apistol78/retrodack/docs/parts.ods

Name | JLCPCB PN | Manufacturer PN | Price | Misc
SODIMM DDR2 connector | C428482 | 1473005-4 | 3.858
SODIMM DDR2 connector | C86474 | 1473005-1 | 3.993
HyperPixel 4 screen |  |  |  | 150 mA
ECP5 |  |  |  | 700 mA
SRAM | C2959389 | CY7C1061G30-10ZSXI | 28.4115 | 16 Mbit | 5 | Fmax = 110
SD card connector | C569097 | 10067847-001RLF | 1.335
SD card connector | C506790 | DM1AA-SF-PEJ(82) | 2.8245
I2S sound DAC | C1520745 | CS4344-CZZ | Discontinued | Discontinued | Discontinued | Discontinued
Speakers |  | JST 1.25
Speakers Amplifier |  | MAX9715xTE+
Speakers Amplifier | C7717 | TPA2012D2RTJR
Headphone Amplifier | C2864655 | TPA4411RTJR
Battery connector |  | JST-PH
USB C charge port
Battery management IC | C81080 | BQ24040DSQR | 0.3314
Linear regulator 3V3 (for display) | C2877852 | TLV75801PDBVR
Buck boost reg 5V0 (for display) | C116655 | TPS63002DRCR
ESD | C328026 | ESD7104MUTAG
USB IC | C2651881 | MAX3421EEHJ+T
Inductor | C36409 | SWPA4030S2R2MT
Tantalum Cap | C7190 | TAJA476K006RNJ
https://www.youtube.com/watch?v=wy2Sr5DGSmc
