apistol78/retrodack/schematics/audio_eval01/audio_eval01/jlcpcb/production_files/BOM-audio.csv

Comment | Designator | Footprint | LCSC | Quantity
22uF | C11,C13,C2,C3,C5,C7,C9 | C_0805_2012Metric_Pad1.18x1.45mm_HandSolder | C15850 | 7
4k7 | R1,R2,R3 | R_0805_2012Metric_Pad1.20x1.40mm_HandSolder | C17673 | 3
~ | U1 | QFN50P500X500X100-33N | C2667049 | 1
0.1uF | C1,C10,C12,C14,C4,C6,C8 | C_0805_2012Metric_Pad1.18x1.45mm_HandSolder | C28233 | 7
AMS1117-1.8 | U2 | SOT-223-3_TabPin2 | C6185 | 1
47uF | C25 | CP_EIA-3216-18_Kemet-A | C7190 | 1
Conn_01x02_Pin | J3 | PinHeader_1x02_P2.54mm_Vertical |  | 1
Conn_01x10_Pin | J1 | PinHeader_1x10_P2.54mm_Vertical |  | 1
AudioJack3 | J2 | Jack_3.5mm_Switronic_ST-005-G_horizontal |  | 1
