apistol78/retrodack/schematics/mainboard/mainboard.step

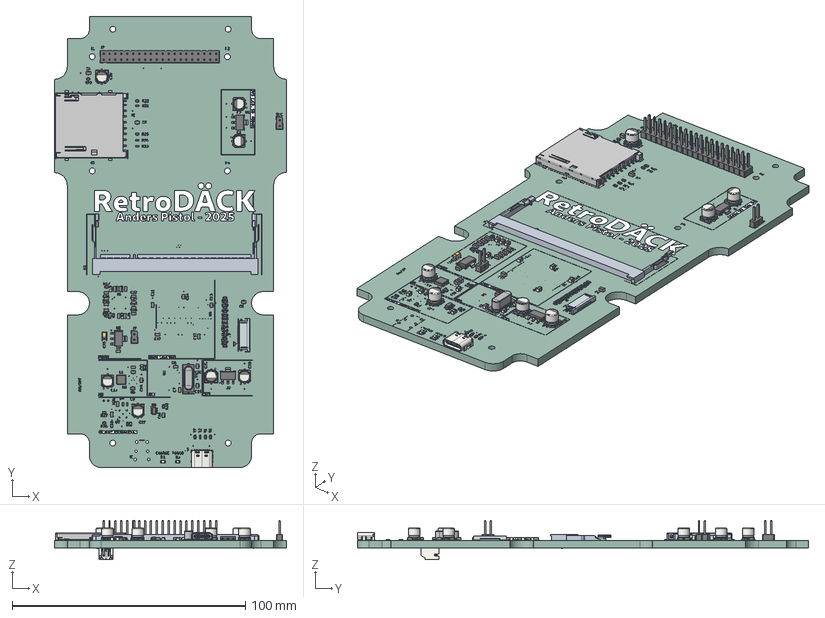
[picture p14: CAD file, 2025-05-28]
schematics/mainboard/mainboard.step
99.5 x 193.5 x 16.8 mm
SOT-223 x 3
PinHeader_1x02_P2.54mm_Vertical x 2
R_0603_1608Metric x 31
C_0805_2012Metric x 32
CP_Elec_5x5.3 x 7
LED_0805_2012Metric x 2
R_0805_2012Metric
L_APV_ANR4012
CP_EIA-3216-18_Kemet-A
Crystal_SMD_HC49-SD
RetroDACK SD_Hirose_DM1AA_SF_PEJ82
USB_C_Receptacle_GCT_USB4105-xx-A_16P_TopMnt_Horizontal
PinHeader_2x20_P2.54mm_Vertical
SOT-23-6
JST_PH_S2B-PH-K_1x02_P2.00mm_Horizontal
mainboard_silkscreen
mainboard_PCB
