apistol78/retrodack/schematics/buttboard/buttboard/buttboard.step

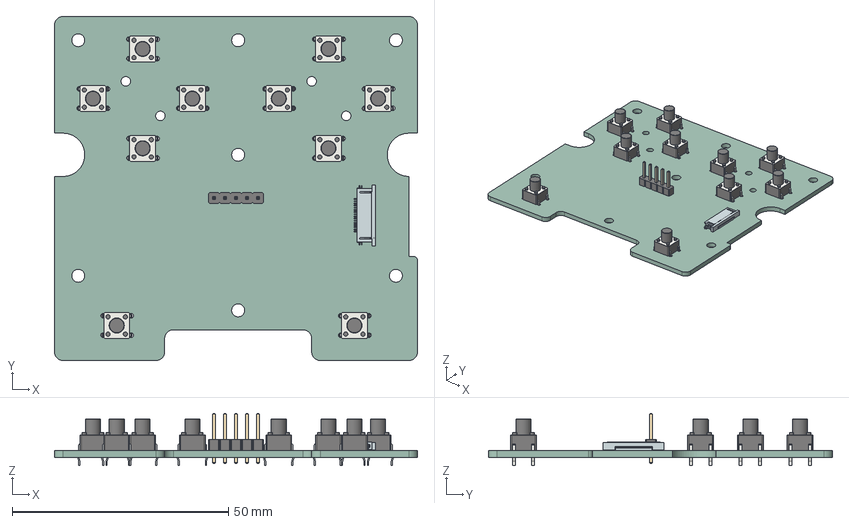
[picture p15: CAD file, 2025-07-03]
schematics/buttboard/buttboard/buttboard.step
84.0 x 79.6 x 12.0 mm
PinHeader_1x05_P2.54mm_Vertical
SW_PUSH_6mm_H7.3mm x 10
buttboard_PCB
