apistol78/retrodack/docs/C145812.pdf

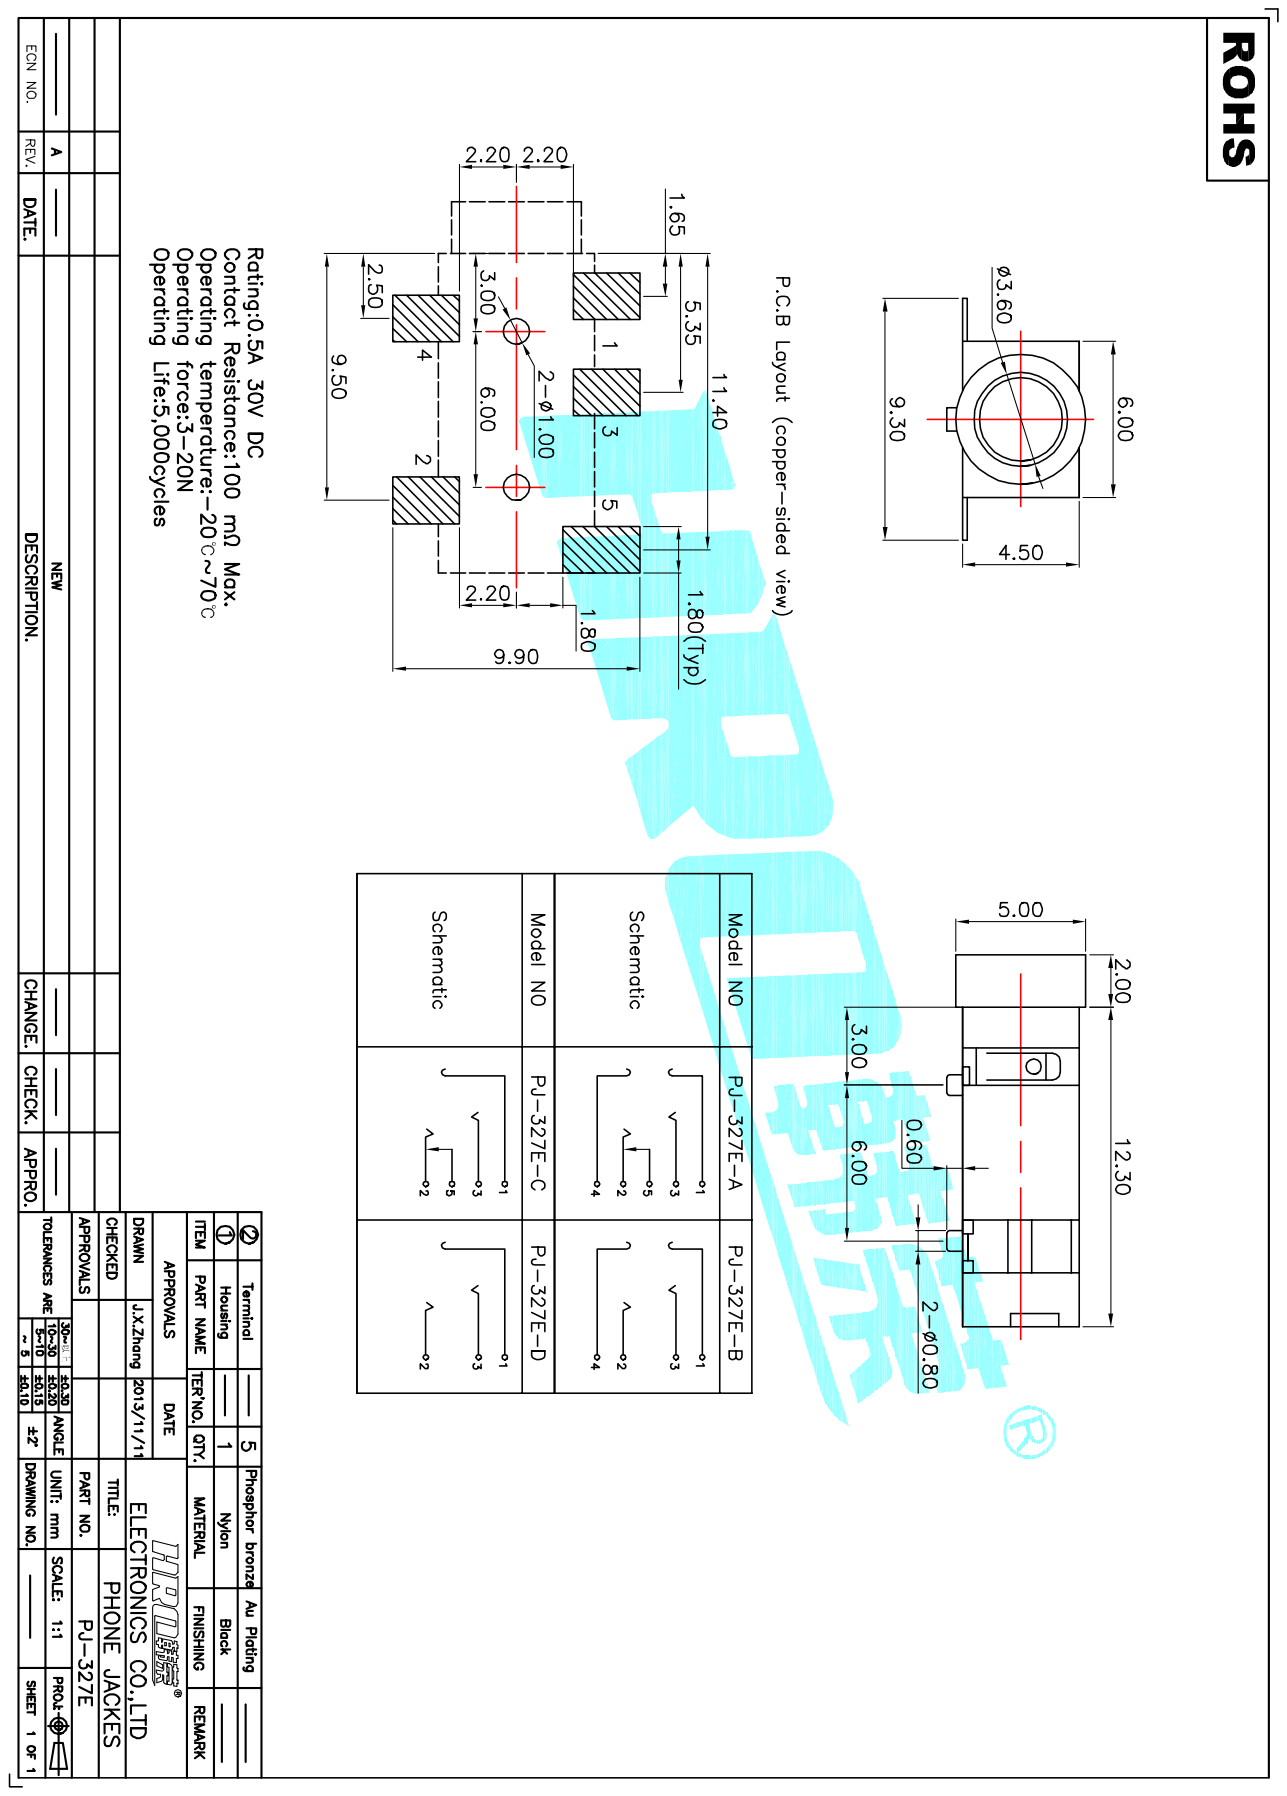
[picture p16: page 1]
