apistol78/retrodack/schematics/fpgaboard/fpgaboard/fpgaboard.kicad_pcb

## KiCad design schematics/fpgaboard/fpgaboard/fpgaboard.kicad_pcb (2026-01-13)

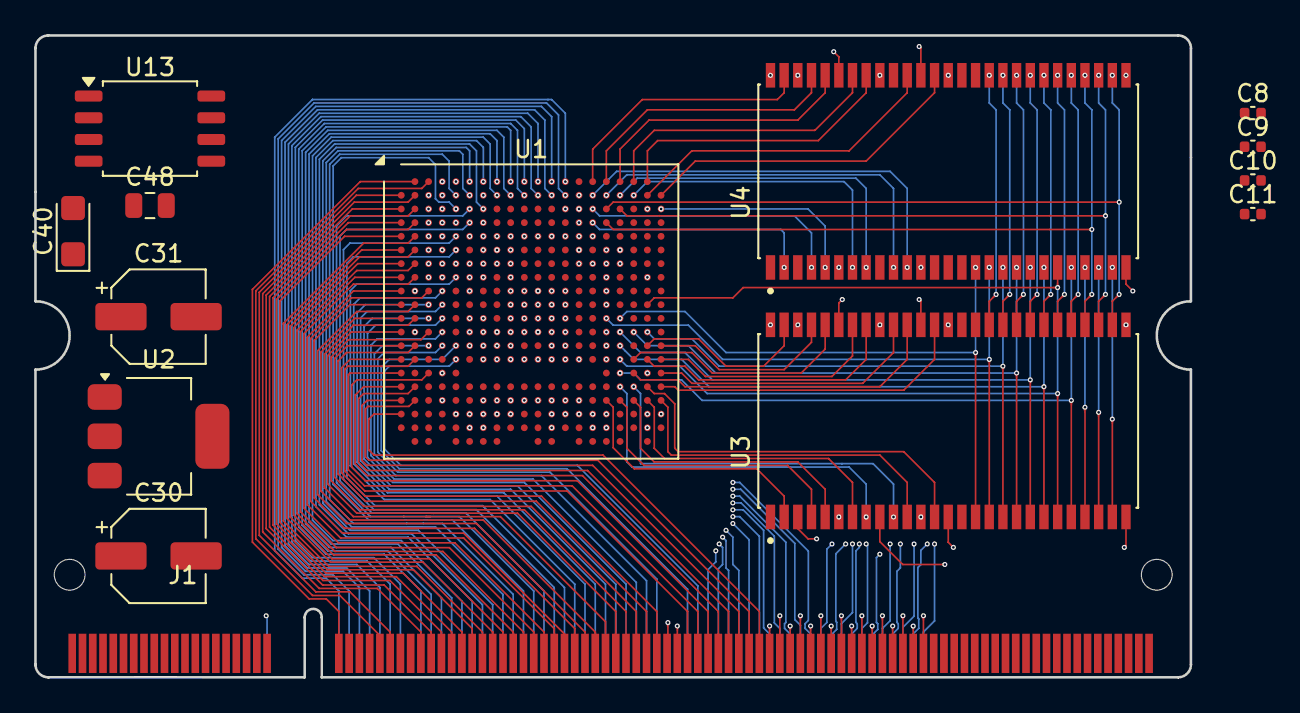
[picture p17: board fpgaboard.kicad_pcb from above]

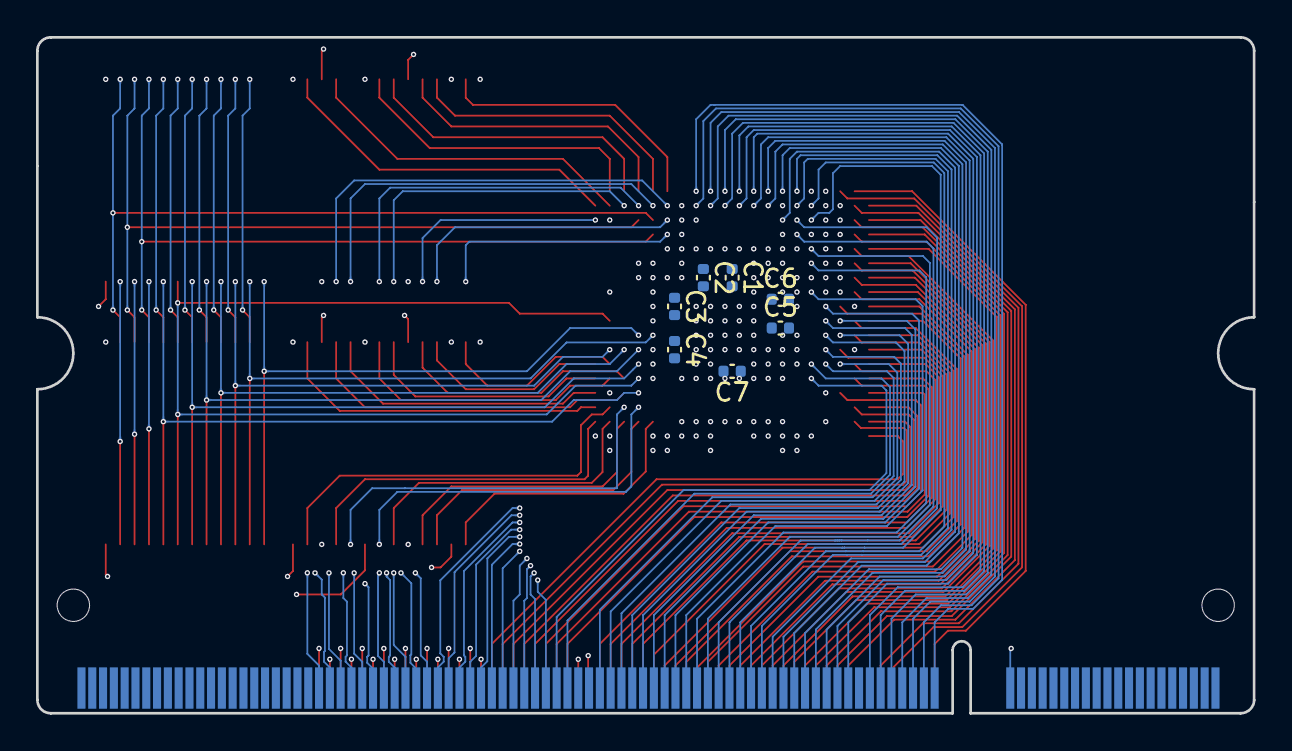
[picture p18: board fpgaboard.kicad_pcb from below]

Board: 6 copper layers, 67.6 x 37.5 mm, 21 parts (7 on the bottom side), 171 nets.

Parts:
C1, C2, C3, C4, C5, C6, C7, C8, C9, C10, C11: C_Small; C_0402_1005Metric
C30: 10uF; CP_Elec_5x5.3
C31: 22uF; CP_Elec_5x5.3
C40: 47uF; CP_EIA-3216-18_Kemet-A
C48: 1uF; C_0805_2012Metric
J1: SODIMM-200; SODIMM_DDR2_EDGE
U1: LFE5UM-85F-8BG381I; Lattice_caBGA-381_17x17mm_Layout20x20_P0.8mm
U2: AMS1117-3.3; SOT-223-3_TabPin2
U3, U4: IS42S16320F-7TL; SOP80P1176X120-54N
U13: W25Q32JVSS; SOIC-8_5.3x5.3mm_P1.27mm

Connections:
1v1: U1.H8 (VCC), U1.H9 (VCC), U1.H10 (VCC), U1.H11 (VCC), U1.H12 (VCC), U1.H13 (VCC), U1.J8 (VCC), U1.J13 (VCC), U1.K8 (VCC), U1.K13 (VCC), U1.L8 (VCC), U1.L13 (VCC), U1.M8 (VCC), U1.M13 (VCC), U1.N8 (VCC), U1.N9 (VCC), U1.N10 (VCC), U1.N11 (VCC), U1.N12 (VCC), U1.N13 (VCC)
5V0: C30.1, J1.2, J1.4, J1.6, J1.8, J1.10, J1.12, U2.3 (VI)
FLASH_CLK: U1.U3 (CCLK), U13.6 (CLK)
FLASH_CSn: U1.R2 (PB15A), U13.1 (~CS)
FLASH_IO0: U1.W2 (PB11B), U13.5 (DI/IO_{0})
FLASH_IO1: U1.V2 (PB11A), U13.2 (DO/IO_{1})
FLASH_IO2: U1.Y2 (PB9B), U13.3 (~WP/IO_{2})
FLASH_IO3: U1.W1 (PB9A), U13.7 (~HOLD/~RESET/IO_{3})
GND: C1.2, C2.2, C3.2, C4.2, C5.2, C6.2, C7.2, C8.2, C9.2, C10.2, C11.2, C30.2, C31.2, C40.2, C48.1, J1.1, J1.3, J1.5, J1.7, J1.9, J1.11, J1.39, J1.40, J1.55, J1.56, J1.105, J1.106, J1.107, J1.108, J1.157, J1.158, J1.199, J1.200, U1.B7 (GND), U1.B14 (GND), U1.C19 (GND), U1.D4 (GND), U1.F7 (GND), U1.F8 (GND), U1.F13 (GND), U1.F14 (GND), U1.G4 (GND), U1.G6 (GND), U1.G7 (GND), U1.G8 (GND), U1.G9 (GND), U1.G10 (GND), U1.G11 (GND), U1.G12 (GND), U1.G13 (GND), U1.G14 (GND), U1.G15 (GND), U1.G17 (GND), U1.H19 (GND), U1.J2 (GND), U1.J7 (GND), U1.J9 (GND), U1.J10 (GND), U1.J11 (GND), U1.J12 (GND), U1.J14 (GND), U1.K6 (GND), U1.K7 (GND), U1.K9 (GND), U1.K10 (GND), U1.K11 (GND), U1.K12 (GND), U1.K14 (GND), U1.K15 (GND), U1.L9 (GND), U1.L10 (GND), U1.L11 (GND), U1.L12 (GND), U1.M2 (GND), U1.M7 (GND), U1.M9 (GND), U1.M10 (GND), U1.M11 (GND), U1.M12 (GND), U1.M14 (GND), U1.M16 (GND), U1.N6 (GND), U1.N7 (GND), U1.N14 (GND), U1.N15 (GND), U1.P7 (GND), U1.P8 (GND), U1.P11 (GND), U1.P12 (GND), U1.P13 (GND), U1.P14 (GND), U1.R4 (CFG_2), U1.R19 (GND), U1.U4 (CFG_0), U1.U7 (GND), U1.U8 (GND), U1.U9 (GND), U1.U10 (GND), U1.U11 (GND), U1.U12 (GND), U1.U13 (GND), U1.U14 (GND), U1.V5 (GND), U1.V6 (GND), U1.V7 (GND), U1.V8 (GND), U1.V9 (GND), U1.V12 (GND), U1.V13 (GND), U1.V14 (GND), U1.V15 (GND), U1.V16 (GND), U1.V19 (GND), U1.V20 (GND), U1.W6 (GND), U1.W7 (GND), U1.W12 (GND), U1.W15 (GND), U1.W16 (GND), U1.W19 (GND), U2.1 (GND), U3.6 (VSSQ), U3.12 (VSSQ), U3.28 (VSS), U3.41 (VSS), U3.46 (VSSQ), U3.52 (VSSQ), U3.54 (VSS), U4.6 (VSSQ), U4.12 (VSSQ), U4.28 (VSS), U4.41 (VSS), U4.46 (VSSQ), U4.52 (VSSQ), U4.54 (VSS), U13.4 (GND)
IO_3v3: C1.1, C2.1, C3.1, C4.1, C5.1, C6.1, C7.1, C8.1, C9.1, C10.1, C11.1, C31.1, C40.1, C48.2, U1.F9 (VCCIO0), U1.F10 (VCCIO0), U1.F11 (VCCIO1), U1.F12 (VCCIO1), U1.H6 (VCCIO7), U1.H7 (VCCIO7), U1.H14 (VCCIO2), U1.H15 (VCCIO2), U1.J6 (VCCIO7), U1.J15 (VCCIO2), U1.L6 (VCCIO6), U1.L7 (VCCIO6), U1.L14 (VCCIO3), U1.L15 (VCCIO3), U1.M6 (VCCIO6), U1.M15 (VCCIO3), U1.P9 (VCCIO8), U1.P10 (VCCIO8), U2.2 (VO), U3.1 (VDD), U3.3 (VDDQ), U3.9 (VDDQ), U3.14 (VDD), U3.27 (VDD), U3.43 (VDDQ), U3.49 (VDDQ), U4.1 (VDD), U4.3 (VDDQ), U4.9 (VDDQ), U4.14 (VDD), U4.27 (VDD), U4.43 (VDDQ), U4.49 (VDDQ), U13.8 (VCC)
unnamed: U1.T6 (VCCA0), U1.U6 (VCCA0)
unnamed: U1.T15 (VCCA1), U1.U15 (VCCA1)
unnamed: U1.F6 (VCCAUX), U1.F15 (VCCAUX), U1.P6 (VCCAUX), U1.P15 (VCCAUX)
unnamed: U1.V10 (VCCAUXA0), U1.V11 (VCCAUXA0)
unnamed: U1.V17 (VCCAUXA1), U1.V18 (VCCAUXA1)
RAM_A0: U1.R17 (PR56D), U3.23 (A0), U4.23 (A0)
RAM_A1: U1.E20 (PR38A), U3.24 (A1), U4.24 (A1)
RAM_A2: U1.F19 (PR38B), U3.25 (A2), U4.25 (A2)
RAM_A3: U1.F20 (PR38C), U3.26 (A3), U4.26 (A3)
RAM_A4: U1.C16 (PT112A), U1.G20 (PR38D), U3.29 (A4), U4.29 (A4)
RAM_A5: U1.C17 (PT114B), U1.G19 (PR41A), U3.30 (A5), U4.30 (A5)
RAM_A6: U1.D16 (PT112B), U1.H20 (PR41B), U3.31 (A6), U4.31 (A6)
RAM_A7: U1.J18 (PR41C), U3.32 (A7), U4.32 (A7)
RAM_A8: U1.K18 (PR41D), U3.33 (A8), U4.33 (A8)
RAM_A9: U1.J19 (PR44A), U3.34 (A9), U4.34 (A9)
RAM_A10: U1.P17 (PR53D), U3.22 (A10), U4.22 (A10)
RAM_A11: U1.J20 (PR44C), U3.35 (A11), U4.35 (A11)
RAM_A12: U1.K20 (PR44D), U3.36 (A12), U4.36 (A12)
RAM_BA0: U1.M17 (PR53B), U3.20 (BA0), U4.20 (BA0)
RAM_BA1: U1.N17 (PR56A), U3.21 (BA1), U4.21 (BA1)
RAM_CKE: U1.M20 (PR47B), U3.37 (CKE), U4.37 (CKE)
RAM_CLK: U1.L20 (PR47A), U3.38 (CLK), U4.38 (CLK)
RAM_D0: U1.U16 (PR92C), U3.2 (DQ0)
RAM_D1: U1.U17 (PR92B), U3.4 (DQ1)
RAM_D2: U1.U18 (PR92A), U3.5 (DQ2)
RAM_D3: U1.U19 (PR89C), U3.7 (DQ3)
RAM_D4: U1.T17 (PR92D), U3.8 (DQ4)
RAM_D5: U1.T18 (PR89D), U3.10 (DQ5)
RAM_D6: U1.U20 (PR86D), U3.11 (DQ6)
RAM_D7: U1.T19 (PR89A), U3.13 (DQ7)
RAM_D8: U1.T20 (PR86C), U3.42 (DQ8)
RAM_D9: U1.R18 (PR89B), U3.44 (DQ9)
RAM_D10: U1.R20 (PR86B), U3.45 (DQ10)
RAM_D11: U1.P19 (PR83C), U3.47 (DQ11)
RAM_D12: U1.P20 (PR86A), U3.48 (DQ12)
RAM_D13: U1.P18 (PR83D), U3.50 (DQ13)
RAM_D14: U1.N20 (PR83B), U3.51 (DQ14)
RAM_D15: U1.N19 (PR83A), U3.53 (DQ15)
RAM_D16: U1.D15 (PT107A), U4.2 (DQ0)
RAM_D17: U1.C15 (PT105B), U4.4 (DQ1)
RAM_D18: U1.C20 (PR35A), U4.5 (DQ2)
RAM_D19: U1.B18 (PT116B), U4.7 (DQ3)
RAM_D20: U1.B17 (PT114A), U4.8 (DQ4)
RAM_D21: U1.B16 (PT110B), U4.10 (DQ5)
RAM_D22: U1.B15 (PT105A), U4.11 (DQ6)
RAM_D24: U1.B20 (PT121B), U4.42 (DQ8)
RAM_D27: U1.A19 (PT121A), U4.47 (DQ11)
RAM_D28: U1.A18 (PT119A), U4.48 (DQ12)
RAM_D29: U1.A17 (PT116A), U4.50 (DQ13)
RAM_D30: U1.A16 (PT110A), U4.51 (DQ14)
RAM_D31: U1.A15 (PT103A), U4.53 (DQ15)
S1: J1.41, U1.A2 (PL35A)
S2: J1.49, U1.A3 (PL14C)
S3: J1.51, U1.B1 (PL35B)
S4: J1.57, U1.B2 (PL35C)
S5: J1.59, U1.C1 (PL38A)
S6: J1.61, U1.C2 (PL35D)
S7: J1.63, U1.D1 (PL38B)
S8: J1.65, U1.D2 (PL38C)
S9: J1.67, U1.E1 (PL38D)
S10: J1.69, U1.E2 (PL44D)
S11: J1.71, U1.F1 (PL47B)
S12: J1.73, U1.F2 (PL44C)
S13: J1.75, U1.G1 (PL47D)
S14: J1.77, U1.G2 (PL47A)
S15: J1.79, U1.H1 (PL53C)
S16: J1.81, U1.H2 (PL47C)
S17: J1.83, U1.J1 (PL53B)
S18: J1.85, U1.J3 (PL50C)
S19: J1.87, U1.K1 (PL53D)
S20: J1.89, U1.K2 (PL53A)
S21: J1.91, U1.L1 (PL89C)
S22: J1.93, U1.L2 (PL86D)
S23: J1.95, U1.M1 (PL89B)
S24: J1.97, U1.M3 (PL86B)
S25: J1.99, U1.N1 (PL89D)
S26: J1.101, U1.N2 (PL89A)
S27: J1.103, U1.P1 (PL92A)
S28: J1.109, U1.P2 (PL92B)
S29: J1.111, U1.R1 (PB4A)
S30: J1.113, U1.R3 (PB15B)
S31: J1.115, U1.T1 (PB4B)
S32: J1.117, U1.T2 (PB13A)
S33: J1.119, U1.U1 (PB6A)
S34: J1.121, U1.U2 (PB13B)
S35: J1.123, U1.V1 (PB6B)
S36: J1.125, U1.A4 (PL11A)
S37: J1.127, U1.A5 (PL11B)
S38: J1.129, U1.B3 (PL14D)
S39: J1.131, U1.B4 (PL14B)
S40: J1.133, U1.C3 (PL17C)
S41: J1.135, U1.C4 (PL14A)
S42: J1.137, U1.D3 (PL17D)
S43: J1.139, U1.D5 (PL17B)
S44: J1.141, U1.E3 (PL20B)
S45: J1.143, U1.E4 (PL17A)
S46: J1.145, U1.F3 (PL44B)
S47: J1.147, U1.F4 (PL20A)
S48: J1.149, U1.G3 (PL44A)
S49: J1.151, U1.G5 (PL41B)
S50: J1.153, U1.H3 (PL41D)
S51: J1.155, U1.H4 (PL41A)
S52: J1.42, U1.A13 (PT76B)
S53: J1.44, U1.B13 (PT78A)
S54: J1.46, U1.A12 (PT76A)
S55: J1.48, U1.B12 (PT71A)
S56: J1.50, U1.A11 (PT63B)
S57: J1.52, U1.B11 (PT65A)
S58: J1.54, U1.A10 (PT63A)
S59: J1.58, U1.B10 (PT60B)
S60: J1.60, U1.A9 (PT60A)
S61: J1.62, U1.B9 (PT58A)
S62: J1.64, U1.A8 (PT18B)
S63: J1.66, U1.B8 (PT15B)
S64: J1.68, U1.A7 (PT18A)
S65: J1.70, U1.C7 (PT11B)
S66: J1.72, U1.A6 (PT4A)
S67: J1.74, U1.B6 (PT4B)
S68: J1.76, U1.B5 (PL11C)
S69: J1.78, U1.C5 (PL11D)
S70: J1.80, U1.C6 (PT11A)
S71: J1.82, U1.D6 (PT6B)
S72: J1.84, U1.E5 (PL20C)
S73: J1.86, U1.F5 (PL20D)
S74: J1.88, U1.H5 (PL41C)
S75: J1.90, U1.J4 (PL50A)
S76: J1.92, U1.K3 (PL50D)
S77: J1.94, U1.K4 (PL56A)
S78: J1.96, U1.L3 (PL86C)
S79: J1.98, U1.L4 (PL56C)
S80: J1.100, U1.M4 (PL83A)
S81: J1.102, U1.N3 (PL86A)
S82: J1.104, U1.N4 (PL83C)
S83: J1.110, U1.N5 (PL83B)
S84: J1.112, U1.P5 (PL83D)
S85: J1.114, U1.E6 (PT6A)
S86: J1.116, U1.D7 (PT9B)
S87: J1.118, U1.E7 (PT9A)
S88: J1.120, U1.E8 (PT13A)
S89: J1.122, U1.E9 (PT20B)
S90: J1.124, U1.E10 (PT56B)
S91: J1.126, U1.E11 (PT69B)
S92: J1.128, U1.E12 (PT74B)
S93: J1.130, U1.E13 (PT80B)
S94: J1.132, U1.E14 (PT85B)
S95: J1.134, U1.F16 (PR11D)
S96: J1.136, U1.P16 (PR56B)
S97: J1.138, U1.N16 (PR53A)
S98: J1.140, U1.K16 (PR29A)
S99: J1.142, U1.J16 (PR20D)
S100: J1.144, U1.H16 (PR17D)
S101: J1.146, U1.G16 (PR17C)
S102: J1.148, U1.F17 (PR17A)
S103: J1.150, U1.E15 (PT107B)
S104: J1.152, U1.D14 (PT85A)
S105: J1.154, U1.C13 (PT78B)
S106: J1.156, U1.C14 (PT83B)
~RAM_CAS: U1.L16 (PR50A), U3.17 (~CAS), U4.17 (~CAS)
~RAM_CS: U1.M18 (PR50D), U3.19 (~CS), U4.19 (~CS)
~RAM_RAS: U1.M19 (PR47D), U3.18 (~RAS), U4.18 (~RAS)
~RAM_WE: U1.L17 (PR50B), U3.16 (~WE), U4.16 (~WE)
