apistol78/retrodack/schematics/mainboard/mainboard.kicad_pcb

## KiCad design schematics/mainboard/mainboard.kicad_pcb (2025-11-21)

Schematic: mainboard.kicad_sch, RetroDÄCK

Parts:
C1, C17, C27, C30: 10uF; CP_Elec_5x5.3
C2, C31: 22uF; CP_Elec_5x5.3
C3, C4, C5, C6, C7, C8, C10, C11, C12, C13, C14, C48, C49: 1uF; C_0805_2012Metric
C9: 4.7uF; C_0805_2012Metric
C15, C21, C23, C26, C32, C35, C36: 0.1uF; C_0805_2012Metric_Pad1.18x1.45mm_HandSolder; LCSC C28233
C16, C28, C29: 10uF; C_0805_2012Metric
C18: 0.1uF; C_0805_2012Metric
C19, C20: 27pF; C_0805_2012Metric
C22, C24, C33, C37: 10uF; C_0805_2012Metric_Pad1.18x1.45mm_HandSolder; LCSC C1713
C25, C40, C43, C45: 47uF; CP_EIA-3216-18_Kemet-A; LCSC C7190
C34, C38: 22uF; C_0805_2012Metric_Pad1.18x1.45mm_HandSolder; LCSC C15850
C39: 47uF; CP_Elec_5x5.3
C41: 500pF; C_0805_2012Metric
C42: 10uF; CP_EIA-3216-18_Kemet-A; LCSC C1969735
C44: 0.47uF; C_0805_2012Metric_Pad1.18x1.45mm_HandSolder
C46, C47: 47uF; C_0805_2012Metric_Pad1.18x1.45mm_HandSolder
D1, D3: LED; LED_0805_2012Metric; LCSC C2297
H1, H2, H3, H4, H5, H6, H7, H8: MountingHole; MountingHole_2.5mm
J1: SD_Card_Receptacle; RetroDACK SD_Hirose_DM1AA_SF_PEJ82; LCSC C506790
J2: LCD_CONN; PinHeader_2x20_P2.54mm_Vertical
J3: USB_C_Receptacle_USB2.0_16P; USB_C_Receptacle_GCT_USB4105-xx-A_16P_TopMnt_Horizontal
J4: BATTERY_CONN; JST_PH_S2B-PH-K_1x02_P2.00mm_Horizontal
J5: 527461671; CON_527461671_MOL; LCSC C3169781
J6: SPEAKER_CONN; JST_PH_S2B-PH-K_1x02_P2.00mm_Horizontal
J7: Conn_01x06; PinHeader_1x06_P2.54mm_Vertical
L1: 2.2uH; L_APV_ANR4012; LCSC C36409
P1: 1-1473005-4; TE_1-1473005-4; LCSC C428482
R1, R2: 33; R_0603_1608Metric_Pad0.98x0.95mm_HandSolder
R3, R4: 1.2k; R_0603_1608Metric_Pad0.98x0.95mm_HandSolder
R5: 100; R_0603_1608Metric
R6, R7: 5.1k; R_0603_1608Metric_Pad0.98x0.95mm_HandSolder
R8, R9, R10, R11, R12, R13, R14, R15, R16, R18, R19, R20, R28, R31, R35, R36: 10k; R_0603_1608Metric_Pad0.98x0.95mm_HandSolder
R17, R33, R34: 4k7; R_0603_1608Metric_Pad0.98x0.95mm_HandSolder; LCSC C17673
R21, R22, R23, R24, R25: 4k7; R_0603_1608Metric_Pad0.98x0.95mm_HandSolder
R26: 120; R_0603_1608Metric_Pad0.98x0.95mm_HandSolder
R27: 68; R_0603_1608Metric_Pad0.98x0.95mm_HandSolder
R29: 0; R_0805_2012Metric_Pad1.20x1.40mm_HandSolder
R30: 10m (1%, 1W); R_0805_2012Metric
R32: NC; R_0603_1608Metric_Pad0.98x0.95mm_HandSolder
S1: SSSS811101; SW_SSSS811101; PARTREV N/A
U1, U2: AMS1117-3.3; SOT-223-3_TabPin2
U3: MAX3421EETJ_T; QFP50P700X700X120-32N; LCSC C2651881
U4: SOP80P1176X120-54N; LCSC C2959389
U5: AMS1117-1.8; SOT-223-3_TabPin2; LCSC C6185
U6: TPS63002; Texas_DRC0010J_ThermalVias; LCSC C116655
U7: BQ24072RGT; VQFN-16-1EP_3x3mm_P0.5mm_EP1.6x1.6mm; LCSC C81080
U8: QFN50P500X500X100-33N; LCSC C2667049
U9: TPS22917DBV; SOT-23-6; LCSC C2681320
U10: PCA9555PW; TSSOP-24_4.4x7.8mm_P0.65mm; LCSC C128392
U11: PJ-327E-5A; LCSC C145812
U13: W25Q32JVSS; SOIC-8_5.3x5.3mm_P1.27mm; LCSC C82344
U14: DS3231MZ; SOIC-8_3.9x4.9mm_P1.27mm; LCSC C107410
U15: BQ27441DRZT-G1A; Texas_S-PDSO-N12; LCSC C2864880
Y1: 12MHz; Crystal_SMD_HC49-SD

Connections:
1V8: C21.1, C22.1, C25.1, U5.2 (VO), U8.3 (DVDD)
3V3: C6.1, C7.1, C8.2, C10.2, C11.2, C12.2, C13.2, C14.2, C23.1, C24.1, C26.1, C31.1, C33.1, C35.1, C37.1, C40.1, C42.1, C49.2, J5.15, R8.2, R9.2, R10.2, R11.2, R12.2, R13.2, R14.2, R15.2, R16.2, R17.1, R18.2, R20.2, R33.1, R34.1, R36.2, U2.2 (VO), U3.2 (VL), U3.23 (VCC), U4.2 (VCC), U4.14 (VCC), U4.16 (~CE2), U4.23 (VCC), U4.29 (VCC), U4.50 (VCC), U5.3 (VI), U8.2 (IOVDD), U8.17 (AVDD), U8.28 (HPVDD), U10.24 (VDD), U14.2 (VCC)
3V3_LCD: C2.1, C3.2, C4.2, C39.1, C43.1, C48.2, J1.4 (VDD), J1.14 (CARD_DETECT), J2.1, J2.17, R21.2, R22.2, R23.2, R24.2, R25.2, U1.2 (VO), U13.8 (VCC)
5V0: C1.1, C16.2, C29.2, C30.1, C32.1, C34.1, C36.1, C38.1, C45.1, J2.2, J2.4, P1.2, P1.4, P1.6, P1.8, P1.10, P1.12, U1.3 (VI), U2.3 (VI), U6.1 (VOUT), U6.10 (FB), U8.21 (SPKVDD), U8.24 (SPKVDD)
AUDIO_BCLK: P1.66, U8.7 (BCLK)
AUDIO_DIN: P1.70, U8.5 (DIN)
AUDIO_INTERRUPT: P1.72, U8.32 (GPIO1)
AUDIO_MCLK: P1.64, U8.8 (MCLK)
AUDIO_WCLK: P1.68, U8.6 (WCLK)
BAT+: J4.1, R30.2, U15.6 (BAT), U15.8 (SRP)
BAT_SYS+: C9.2, R30.1, U7.2 (BAT), U7.3 (BAT), U14.6 (VBAT), U15.7 (SRN)
FLASH_CLK: P1.92, U13.6 (CLK)
FLASH_CSn: P1.84, U13.1 (~CS)
FLASH_IO0: P1.90, U13.5 (DI/IO_{0})
FLASH_IO1: P1.86, U13.2 (DO/IO_{1})
FLASH_IO2: P1.88, U13.3 (~WP/IO_{2})
FLASH_IO3: P1.94, U13.7 (~HOLD/~RESET/IO_{3})
GND: C1.2, C2.2, C3.1, C4.1, C5.1, C6.2, C7.2, C8.1, C9.1, C10.1, C11.1, C12.1, C13.1, C14.1, C15.2, C16.1, C17.2, C18.1, C19.1, C20.1, C21.2, C22.2, C23.2, C24.2, C25.2, C26.2, C27.2, C28.1, C29.1, C30.2, C31.2, C32.2, C33.2, C34.2, C35.2, C36.2, C37.2, C38.2, C39.2, C40.2, C42.2, C43.2, C44.2, C45.2, C48.1, C49.1, J1.3 (VSS), J1.6 (VSS), J1.12 (SHELL1), J1.13 (SHELL2), J2.6, J2.9, J2.14, J2.20, J2.25, J2.30, J2.34, J2.39, J3.A1 (GND), J3.A12 (GND), J3.B1 (GND), J3.B12 (GND), J3.S1 (SHIELD), J4.2, J5.1, J5.P1, J5.P2, J7.1, P1.1, P1.3, P1.5, P1.7, P1.9, P1.11, P1.39, P1.40, P1.55, P1.56, P1.105, P1.106, P1.107, P1.108, P1.157, P1.158, P1.199, P1.200, R3.2, R4.2, R6.1, R7.1, R19.2, R28.2, R35.2, U1.1 (GND), U2.1 (GND), U3.3 (GND), U3.19 (GND), U4.5 (VSS), U4.13 (~CE1), U4.26 (VSS), U4.32 (VSS), U4.41 (VSS), U4.53 (VSS), U5.1 (GND), U6.3 (PGND), U6.9 (GND), U6.11 (PGND), U7.4 (~CE), U7.6 (EN1), U7.8 (VSS), U7.17 (VSS), U8.1 (IOVSS), U8.13 (AIN1), U8.14 (AIN2), U8.16 (AVSS), U8.18 (DVSS), U8.20 (SPKVSS), U8.25 (SPKVSS), U8.29 (HPVSS), U9.2 (GND), U10.2 (A1), U10.3 (A2), U10.12 (VSS), U10.21 (A0), U11.1 (GND), U13.4 (GND), U14.5 (GND), U15.3 (V_{SS})
I2C_SCL: J5.13, P1.60, R34.2, U8.10 (SCL), U10.22 (SCL), U14.8 (SCL), U15.2 (SCL)
I2C_SDA: J5.12, P1.58, R33.2, U8.9 (SDA), U10.23 (SDA), U14.7 (SDA), U15.1 (SDA)
KEYPAD_INTERRUPT: P1.155, R18.1, U10.1 (~INT)
LCD_B0: J2.7, P1.114
LCD_B1: J2.29, P1.142
LCD_B2: J2.31, P1.144
LCD_B3: J2.26, P1.136
LCD_B4: J2.24, P1.134
LCD_B5: J2.21, P1.132
LCD_BACKLIGHT_CTRL: J2.35, P1.152
LCD_CLK: J2.27, P1.138
LCD_CS: J2.12, P1.122
LCD_ENABLE: J2.28, P1.140
LCD_G0: J2.32, P1.146
LCD_G1: J2.33, P1.148
LCD_G2: J2.8, P1.116
LCD_G3: J2.10, P1.118
LCD_G4: J2.36, P1.150
LCD_G5: J2.11, P1.120
LCD_HSYNC: J2.5, P1.112
LCD_R0: J2.38, P1.154
LCD_R1: J2.40, P1.156
LCD_R2: J2.15, P1.126
LCD_R3: J2.16, P1.124
LCD_R4: J2.18, P1.128
LCD_R5: J2.22, P1.130
LCD_VSYNC: J2.3, P1.110
unnamed: D1.2 (A), R27.2
unnamed: D1.1 (K), U7.9 (~CHG)
unnamed: D3.2 (A), R26.2
unnamed: D3.1 (K), U7.7 (~PGOOD)
unnamed: J3.A5 (CC1), R7.2
unnamed: J3.B5 (CC2), R6.2
unnamed: J6.1, U8.22 (SPKP), U8.26 (SPKP)
unnamed: J6.2, U8.19 (SPKM), U8.23 (SPKM)
unnamed: J7.2, P1.82
unnamed: J7.3, P1.80
unnamed: J7.4, P1.78
unnamed: J7.5, P1.76
unnamed: J7.6, P1.74
unnamed: R1.2, U3.21 (D+)
unnamed: R2.2, U3.20 (D-)
unnamed: C5.2, R29.1, U3.22 (VBCOMP)
unnamed: C18.2, R5.1, U6.6 (EN), U6.7 (PS/SYNC), U6.8 (VINA)
unnamed: L1.2, U6.4 (L1)
unnamed: L1.1, U6.2 (L2)
unnamed: C28.2, C41.1, R26.1, R27.1, S1.2, U7.5 (EN2), U7.10 (OUT), U7.11 (OUT), U7.15 (TD), U9.1 (VIN)
unnamed: R3.1, U7.12 (ILIM)
unnamed: R4.1, U7.16 (ISET)
unnamed: R28.1, U7.1 (TS)
unnamed: C47.1, U8.27 (HPL)
unnamed: C46.1, U8.30 (HPR)
unnamed: R31.1, U8.12 (MICBIAS)
unnamed: C41.2, U9.4 (CT)
unnamed: R19.1, S1.1, U9.3 (ON)
unnamed: R32.2, U9.5 (QOD)
unnamed: J5.2, R8.1, U10.4 (IO0_0)
unnamed: J5.3, R12.1, U10.5 (IO0_1)
unnamed: J5.4, R9.1, U10.6 (IO0_2)
unnamed: J5.5, R13.1, U10.7 (IO0_3)
unnamed: J5.6, R10.1, U10.8 (IO0_4)
unnamed: J5.7, R14.1, U10.9 (IO0_5)
unnamed: J5.8, R11.1, U10.10 (IO0_6)
unnamed: J5.9, R15.1, U10.11 (IO0_7)
unnamed: J5.10, R16.1, U10.13 (IO1_0)
unnamed: J5.11, R20.1, U10.14 (IO1_1)
unnamed: R31.2, U8.11 (VOL/MICDET), U11.4 (DETECT_GND)
unnamed: C47.2, U11.2 (LEFT)
unnamed: C46.2, U11.3 (RIGHT)
unnamed: R35.1, U15.10 (BIN)
unnamed: R36.1, U15.12 (GPOUT)
unnamed: C44.1, U15.5 (V_{DD})
SD_CARD: J1.10 (CARD_DETECT), P1.54
SD_CLK: J1.5 (CLK), P1.46
SD_CMD: J1.2 (CMD), P1.48, R25.1
SD_DAT0: J1.7 (DAT0), P1.44, R21.1
SD_DAT1: J1.8 (DAT1), P1.42, R22.1
SD_DAT2: J1.9 (DAT2), P1.52, R23.1
SD_DAT3: J1.1 (CD/DAT3), P1.50, R24.1
SRAM_A0: P1.119, U4.11 (A0)
SRAM_A1: P1.123, U4.10 (A1)
SRAM_A2: P1.127, U4.9 (A2)
SRAM_A3: P1.131, U4.8 (A3)
SRAM_A4: P1.135, U4.7 (A4)
SRAM_A5: P1.133, U4.48 (A5)
SRAM_A6: P1.129, U4.47 (A6)
SRAM_A7: P1.125, U4.46 (A7)
SRAM_A8: P1.121, U4.45 (A8)
SRAM_A9: P1.117, U4.44 (A9)
SRAM_A10: P1.103, U4.38 (A10)
SRAM_A11: P1.99, U4.37 (A11)
SRAM_A12: P1.95, U4.36 (A12)
SRAM_A13: P1.91, U4.35 (A13)
SRAM_A14: P1.87, U4.34 (A14)
SRAM_A15: P1.85, U4.21 (A15)
SRAM_A16: P1.89, U4.20 (A16)
SRAM_A17: P1.93, U4.19 (A17)
SRAM_A18: P1.97, U4.18 (A18)
SRAM_A19: P1.101, U4.17 (A19)
SRAM_D0: P1.81, U4.22 (IO_0)
SRAM_D1: P1.77, U4.24 (IO_1)
SRAM_D2: P1.73, U4.25 (IO_2)
SRAM_D3: P1.69, U4.27 (IO_3)
SRAM_D4: P1.71, U4.28 (IO_4)
SRAM_D5: P1.75, U4.30 (IO_5)
SRAM_D6: P1.79, U4.31 (IO_6)
SRAM_D7: P1.83, U4.33 (IO_7)
SRAM_D8: P1.137, U4.49 (IO_8)
SRAM_D9: P1.141, U4.51 (IO_9)
SRAM_D10: P1.145, U4.52 (IO_10)
SRAM_D11: P1.149, U4.54 (IO_11)
SRAM_D12: P1.151, U4.1 (IO_12)
SRAM_D13: P1.147, U4.3 (IO_13)
SRAM_D14: P1.143, U4.4 (IO_14)
SRAM_D15: P1.139, U4.6 (IO_15)
SYS_LOAD: C17.1, R5.2, R32.1, U6.5 (VIN), U9.6 (VOUT)
TRACKBALL_INTERRUPT: J5.14, P1.62
USB_DN: J3.A7 (D-), J3.B7 (D-), R2.1
USB_DP: J3.A6 (D+), J3.B6 (D+), R1.1
USB_HCI_INT: P1.57, U3.18 (INT)
USB_HCI_MISO: P1.61, U3.15 (MISO)
USB_HCI_MOSI: P1.59, U3.16 (MOSI)
USB_HCI_SCLK: P1.65, U3.13 (SCLK)
USB_HCI_XI: C19.2, U3.24 (XI), Y1.1
USB_HCI_XO: C20.2, U3.25 (XO), Y1.2
USB_VBUS: C27.1, J3.A4 (VBUS), J3.A9 (VBUS), J3.B4 (VBUS), J3.B9 (VBUS), R29.2, U7.13 (IN)
~RESET: C15.1, R17.2, U8.31 (~RESET)
~SRAM_BHE: P1.115, U4.12 (~BHE)
~SRAM_BLE: P1.109, U4.39 (~BLE)
~SRAM_OE: P1.113, U4.42 (~OE)
~SRAM_WE: P1.111, U4.15 (~WE)
~USB_HCI_RESET: P1.67, U3.12 (~RES)
~USB_HCI_SS: P1.63, U3.14 (~SS)

Notes on the sheet:
SRAM
SD CARD
BATTERY MNGR
TLV320 I2C address 0x18
CE2 if U4 is NOT inverted! Symbol incorrect!
I2C address 0x55 (7-bit)
Trackball I2C address 0x0A
REGULATORS
I2C address 0xD0
AUDIO
I2C address 0x40
NV STORAGE
Switch current min 1600 mA
INPUT CONNECTORS
USB INTERFACE
LCD CONNECTOR
RTC
Battery terminal JST-PH
TODO -GPIO with debounce? +Battery ADC -Charge signal to FPGA (open drain?) -What if battery/USB are connected at the same time as "ice" USB? -Power switch, larger? +Headphone detection, MIC/VOLDET need to be pulled down from a R to MIC +Headphone caps on +/- +Improved bulk and filter of 5V

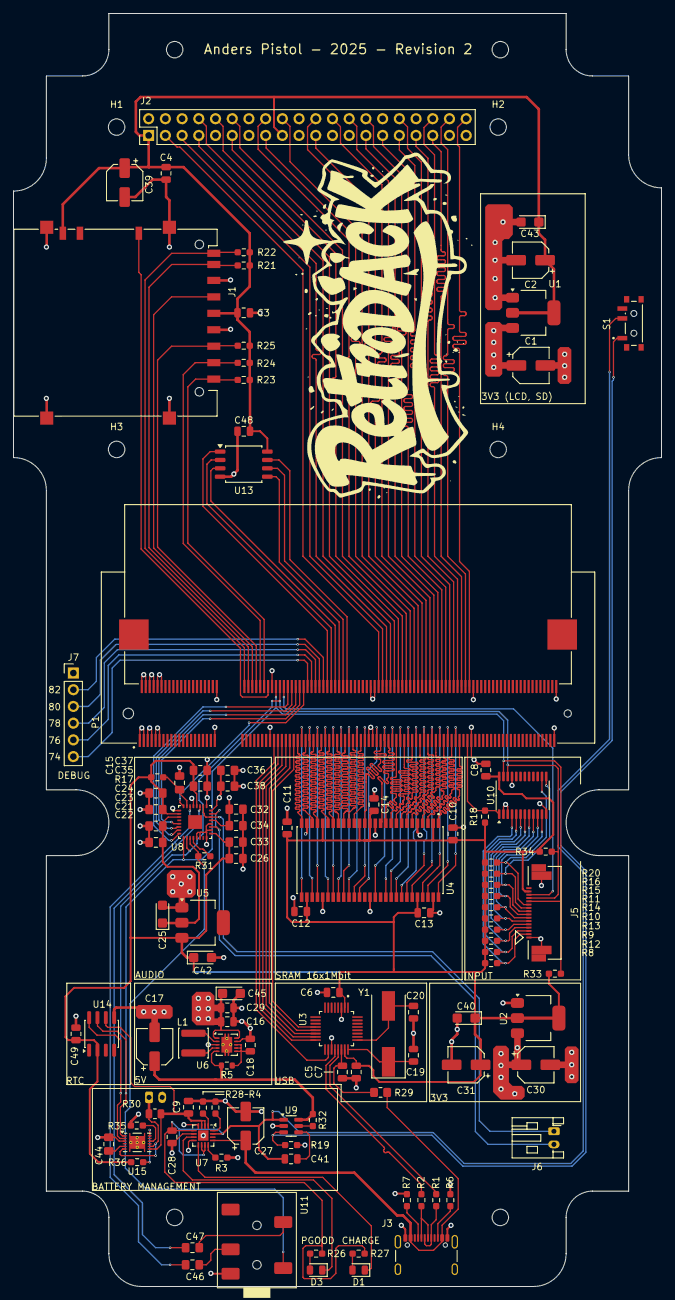
[picture p19: board mainboard.kicad_pcb from above]

Board: 4 copper layers, 98.5 x 193.5 mm, 120 parts (1 on the bottom side), 151 nets.
