apistol78/retrodack/schematics/buttboard/buttboard/buttboard.kicad_pcb

## KiCad design schematics/buttboard/buttboard/buttboard.kicad_pcb (2025-07-13)

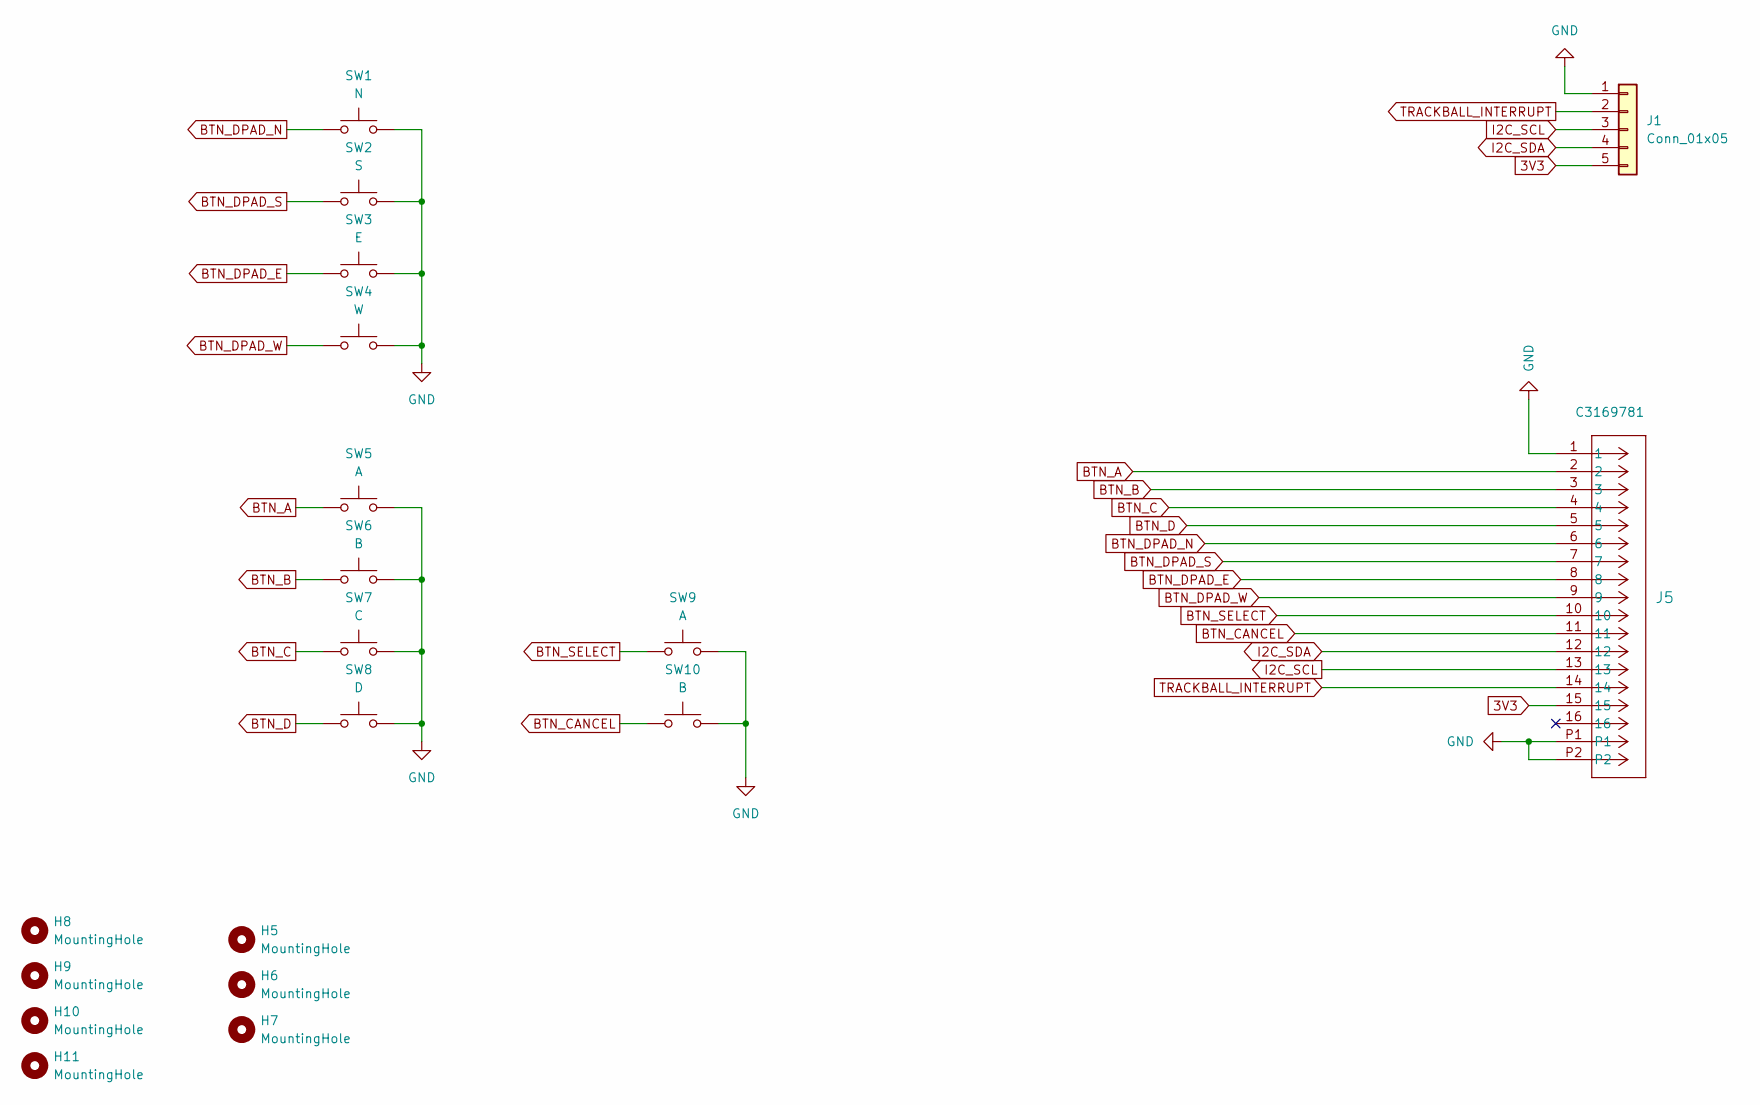
[picture p20: schematic buttboard.kicad_sch]

Parts:
H5, H6, H7, H8, H9, H10, H11: MountingHole; MountingHole_3mm
J1: Conn_01x05; PinHeader_1x05_P2.54mm_Vertical
J5: 527461671; CON_527461671_MOL; LCSC C3169781
SW1: N; SW_PUSH_6mm_H7.3mm
SW2: S; SW_PUSH_6mm_H7.3mm
SW3: E; SW_PUSH_6mm_H7.3mm
SW4: W; SW_PUSH_6mm_H7.3mm
SW5, SW9: A; SW_PUSH_6mm_H7.3mm
SW6, SW10: B; SW_PUSH_6mm_H7.3mm
SW7: C; SW_PUSH_6mm_H7.3mm
SW8: D; SW_PUSH_6mm_H7.3mm

Connections:
3V3: J1.5, J5.15
BTN_A: J5.2, SW5.1
BTN_B: J5.3, SW6.1
BTN_C: J5.4, SW7.1
BTN_CANCEL: J5.11, SW10.1
BTN_D: J5.5, SW8.1
BTN_DPAD_E: J5.8, SW3.1
BTN_DPAD_N: J5.6, SW1.1
BTN_DPAD_S: J5.7, SW2.1
BTN_DPAD_W: J5.9, SW4.1
BTN_SELECT: J5.10, SW9.1
GND: J1.1, J5.1, J5.P1, J5.P2, SW1.2, SW2.2, SW3.2, SW4.2, SW5.2, SW6.2, SW7.2, SW8.2, SW9.2, SW10.2
I2C_SCL: J1.3, J5.13
I2C_SDA: J1.4, J5.12
TRACKBALL_INTERRUPT: J1.2, J5.14

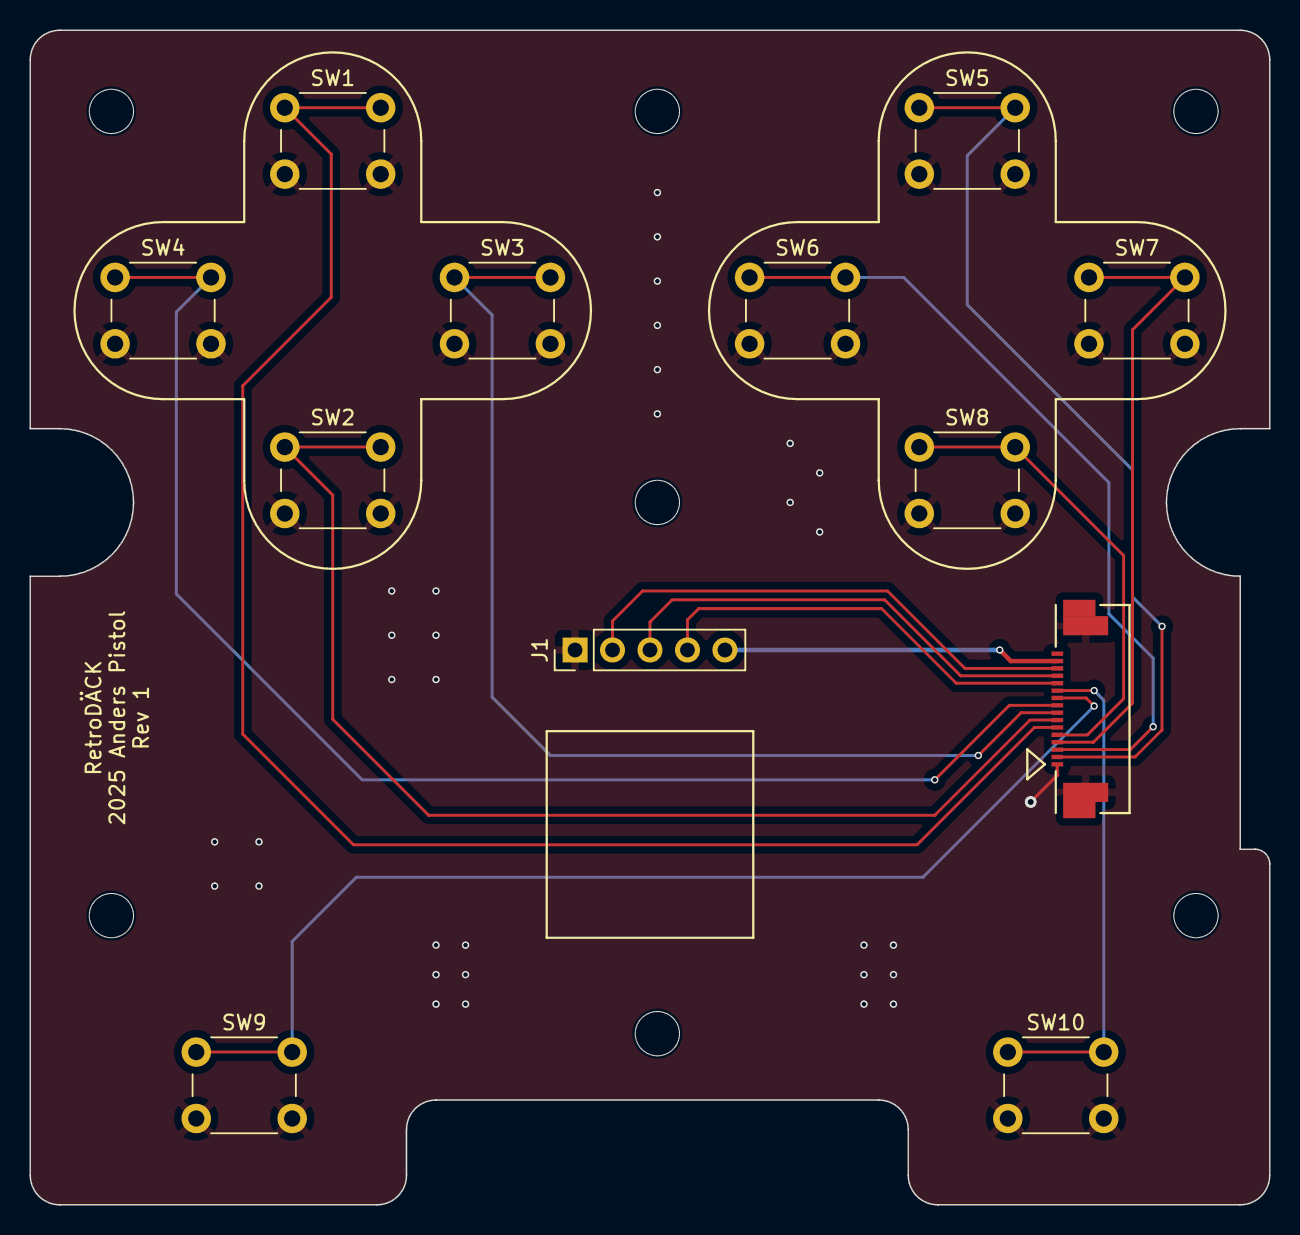
[picture p21: board buttboard.kicad_pcb from above]

Board: 2 copper layers, 84.0 x 79.6 mm, 19 parts (0 on the bottom side), 15 nets.
