apistol78/retrodack/schematics/audio_eval01/audio_eval01/audio_eval01.kicad_pcb

## KiCad design schematics/audio_eval01/audio_eval01/audio_eval01.kicad_pcb (2025-05-22)

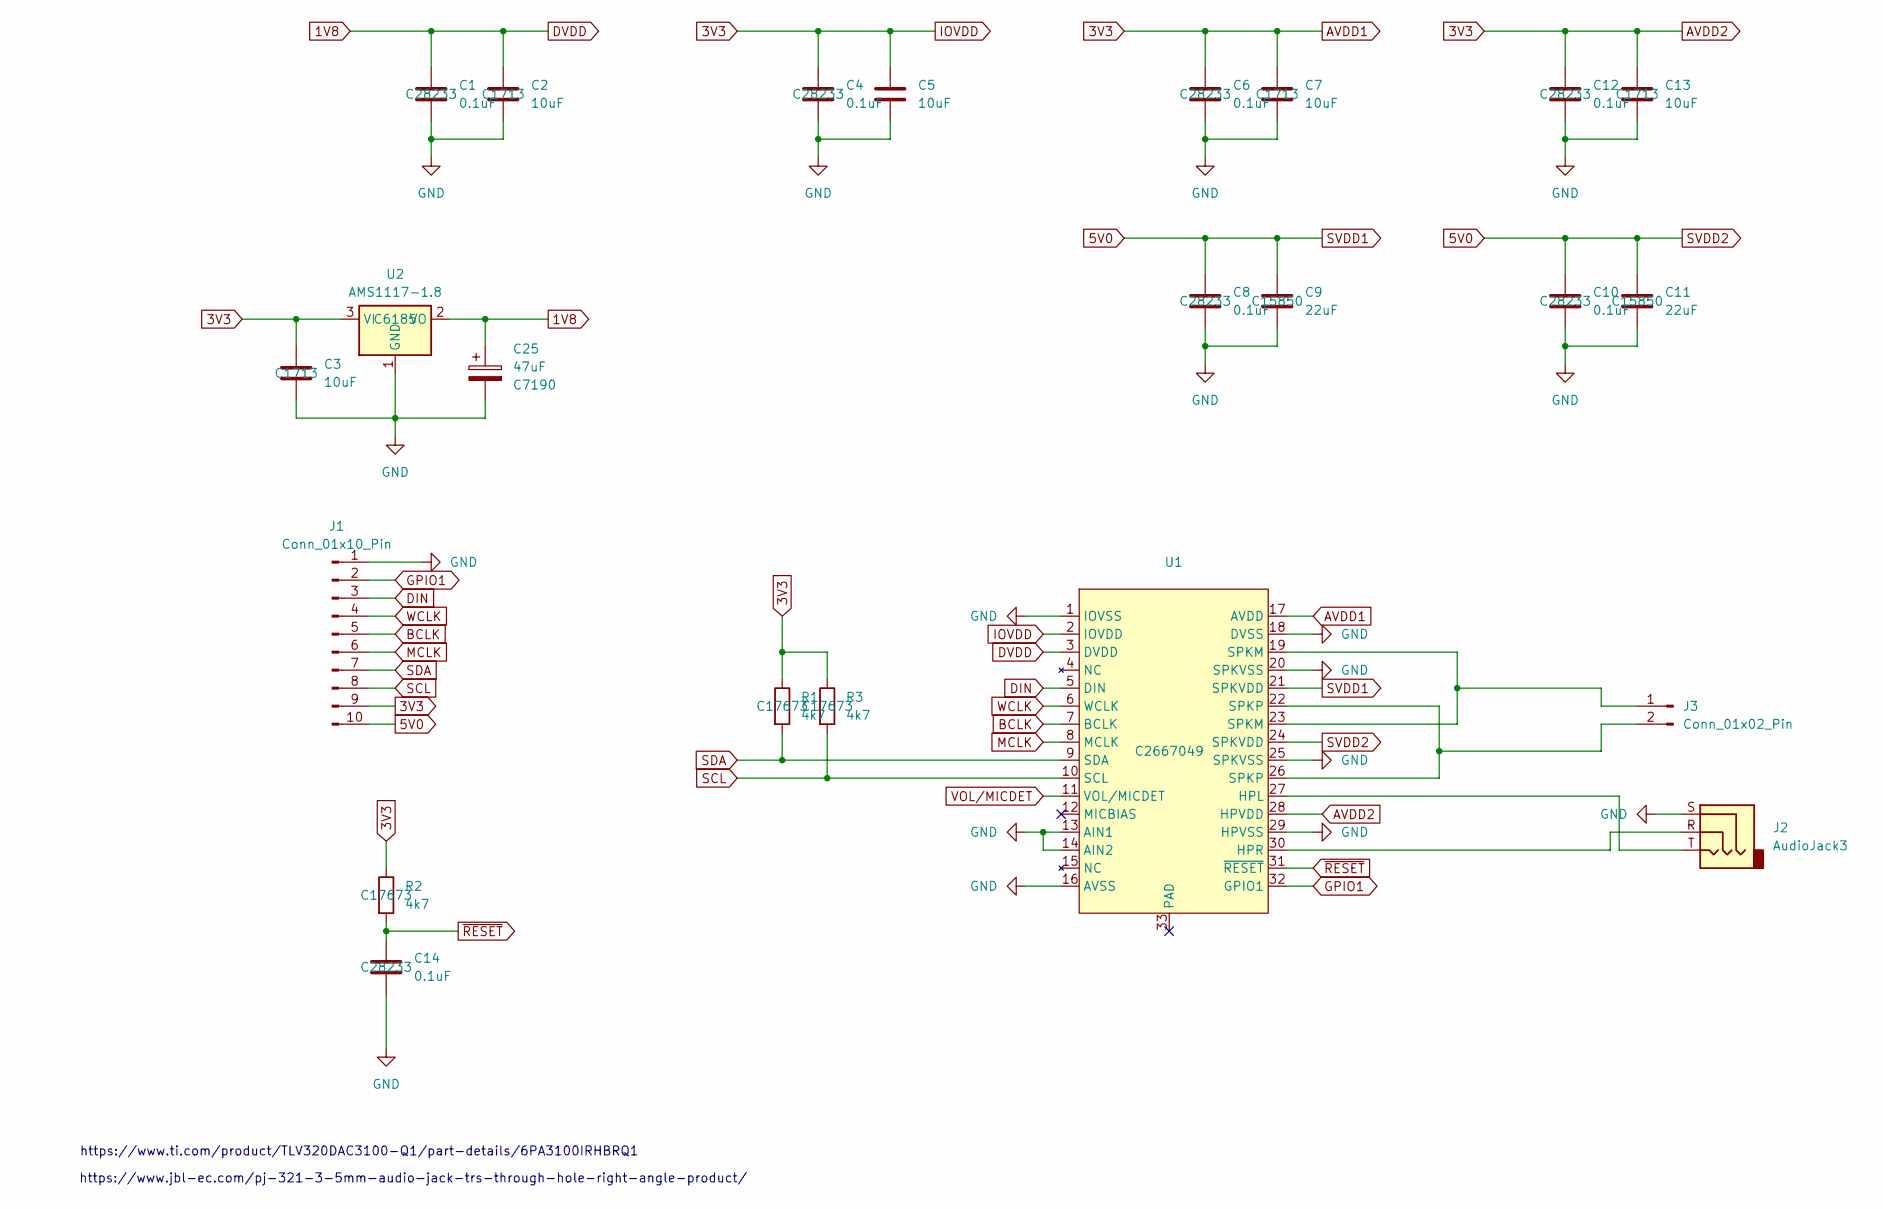
[picture p22: schematic audio_eval01.kicad_sch]

Parts:
C1, C4, C6, C8, C10, C12, C14: 0.1uF; C_0805_2012Metric_Pad1.18x1.45mm_HandSolder; LCSC C28233
C2, C3, C5, C7, C13: 10uF; C_0805_2012Metric_Pad1.18x1.45mm_HandSolder; LCSC C1713
C9, C11: 22uF; C_0805_2012Metric_Pad1.18x1.45mm_HandSolder; LCSC C15850
C25: 47uF; CP_EIA-3216-18_Kemet-A; LCSC C7190
J1: Conn_01x10_Pin; PinHeader_1x10_P2.54mm_Vertical
J2: AudioJack3; Jack_3.5mm_Switronic_ST-005-G_horizontal
J3: Conn_01x02_Pin; PinHeader_1x02_P2.54mm_Vertical
R1, R2, R3: 4k7; R_0805_2012Metric_Pad1.20x1.40mm_HandSolder; LCSC C17673
U1: QFN50P500X500X100-33N; LCSC C2667049
U2: AMS1117-1.8; SOT-223-3_TabPin2; LCSC C6185

Connections:
1V8: C1.1, C2.1, C25.1, U1.3 (DVDD), U2.2 (VO)
3V3: C3.1, C4.1, C5.1, C6.1, C7.1, C12.1, C13.1, J1.9, R1.1, R2.1, R3.1, U1.2 (IOVDD), U1.17 (AVDD), U1.28 (HPVDD), U2.3 (VI)
5V0: C8.1, C9.1, C10.1, C11.1, J1.10, U1.21 (SPKVDD), U1.24 (SPKVDD)
BCLK: J1.5, U1.7 (BCLK)
DIN: J1.3, U1.5 (DIN)
GND: C1.2, C2.2, C3.2, C4.2, C5.2, C6.2, C7.2, C8.2, C9.2, C10.2, C11.2, C12.2, C13.2, C14.2, C25.2, J1.1, J2.S, U1.1 (IOVSS), U1.13 (AIN1), U1.14 (AIN2), U1.16 (AVSS), U1.18 (DVSS), U1.20 (SPKVSS), U1.25 (SPKVSS), U1.29 (HPVSS), U2.1 (GND)
GPIO1: J1.2, U1.32 (GPIO1)
MCLK: J1.6, U1.8 (MCLK)
unnamed: J3.1, U1.19 (SPKM), U1.23 (SPKM)
unnamed: J3.2, U1.22 (SPKP), U1.26 (SPKP)
unnamed: J2.T, U1.27 (HPL)
unnamed: J2.R, U1.30 (HPR)
SCL: J1.8, R3.2, U1.10 (SCL)
SDA: J1.7, R1.2, U1.9 (SDA)
VOL/MICDET: U1.11 (VOL/MICDET)
WCLK: J1.4, U1.6 (WCLK)
~RESET: C14.1, R2.2, U1.31 (~RESET)

Notes on the sheet:
https://www.ti.com/product/TLV320DAC3100-Q1/part-details/6PA3100IRHBRQ1
https://www.jbl-ec.com/pj-321-3-5mm-audio-jack-trs-through-hole-right-angle-product/

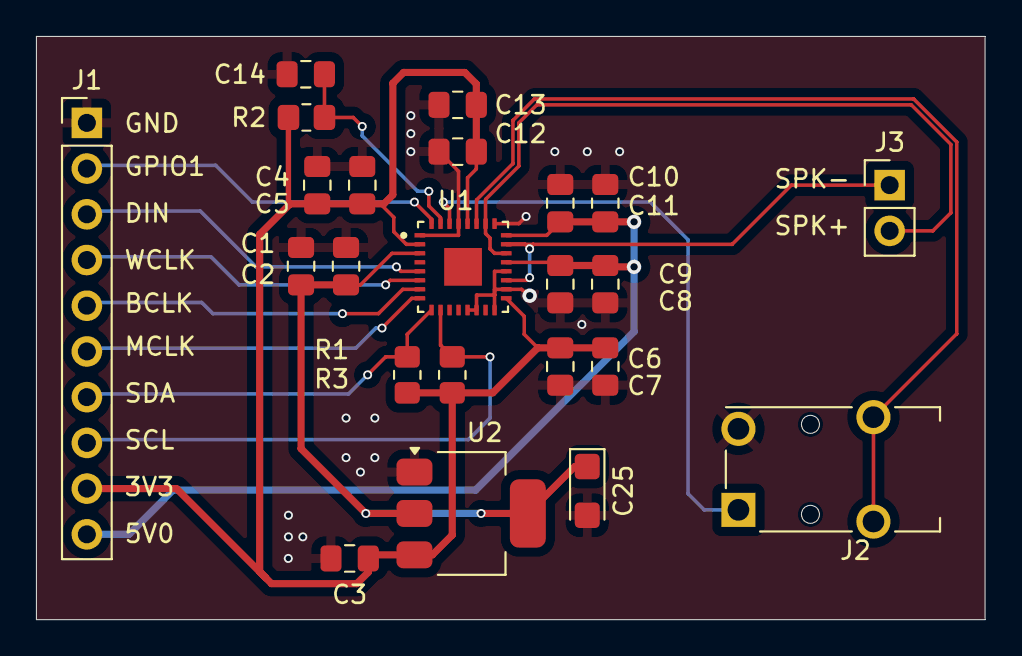
[picture p23: board audio_eval01.kicad_pcb from above]

Board: 2 copper layers, 52.7 x 32.4 mm, 23 parts (0 on the bottom side), 16 nets.
