apistol78/retrodack/docs/scummvm.ini

[scummvm]
mute=false
speech_volume=192
native_mt32=false
midi_gain=100
talkspeed=60
subtitles=false
multi_midi=false
fullscreen=true
updates_check=0
browser_lastpath=.
themepath=.
sfx_volume=192
music_volume=162
speech_mute=false
lastselectedgame=monkey
music_driver=auto
aspect_ratio=true
versioninfo=2.0.0
autosave_period=300
enable_gs=false

[monkey]
description=1. The Secret of Monkey Island
savepath=.\monkey1
path=.\monkey1
sfx_mute=false
subtitles=true
gameid=monkey
music_driver=adlib
kbdmouse_speed=3
speech_mute=false
guioptions=sndNoSpeech sndNoMIDI lang_English

[monkey2]
description=2. Monkey Island 2: LeChuck's Revenge
savepath=.\monkey2
path=.\monkey2
sfx_mute=false
subtitles=true
gameid=monkey
music_driver=adlib
kbdmouse_speed=3
speech_mute=false
guioptions=sndNoSpeech sndNoMIDI lang_English
