apistol78/retrodack/code/ModPlayer/Main.cpp

#include <stdio.h>
#include <stdlib.h>
#include <string.h>
#include <time.h>

#include "Runtime/Runtime.h"

#include <xmp.h>

#define SAMPLE_RATE 22050

xmp_context ctx;
int32_t Cl = 0;
int32_t Cr = 0;

int8_t hist[128];

inline int16_t max(int16_t a, int16_t b)
{
	return (a > b) ? a : b;
}

static void draw_thread()
{
	const int32_t FW = 360;
	const int32_t FH = 360;

	for (;;)
	{
		rt_gfx_context_t ctx;
		ctx.width = FW;
		ctx.height = FH;
		ctx.pixels = (uint8_t*)rt_video_get_secondary_target();

		rt_video_clear(0);
		rt_video_wait();		

		{
			const int32_t w = Cl;
			rt_gfx_fill_rect(&ctx, 90 - w, 180 - w, w * 2, w * 2, 1);
		}
		{
			const int32_t w = Cr;
			rt_gfx_fill_rect(&ctx, 270 - w, 180 - w, w * 2, w * 2, 1);
		}

		for (int32_t i = 1; i < 128; ++i)
		{
			int32_t x0 = (i - 1) * 2 + (360 - 256) / 2;
			int32_t y0 = 180 + hist[i - 1];
			int32_t x1 = (i) * 2 + (360 - 256) / 2;
			int32_t y1 = 180 + hist[i];
			rt_gfx_draw_line(&ctx, x0, y0, x1, y1, 2);
		}

		rt_video_present(1);
	}
}

int main()
{
	FILE *file;
	uint8_t *mod_data;

	runtime_init();
	rt_video_set_mode(VMODE_360_360_8);
	rt_video_set_palette(0, 0x2f7dad);
	rt_video_set_palette(1, 0x9ad2f5);
	rt_video_set_palette(2, 0xffffff);

	rt_kernel_create_thread(draw_thread, "draw");

	rt_audio_set_playback_rate(SAMPLE_RATE);

	if (!(file = fopen("song.mod", "rb")))
		return -1;

	fseek(file, 0, SEEK_END);
	const int32_t mod_size = ftell(file);
	rewind(file);

	if (!(mod_data = (uint8_t*)malloc(mod_size)))
		return -1;
	else if (!fread(mod_data, mod_size, 1, file))
		return -1;
	fclose(file);

	ctx = xmp_create_context();

	xmp_load_module_from_memory(ctx, mod_data, mod_size);

	xmp_start_player(ctx, SAMPLE_RATE, 0);
	xmp_set_player(ctx, XMP_PLAYER_INTERP, XMP_INTERP_LINEAR);

	struct xmp_frame_info fi;
	uint8_t buffer[4][1024 * 2 * sizeof(int16_t)];
	int32_t i = 0;

	while (rt_input_get_state() == 0)
	{
		xmp_play_buffer(ctx, buffer[i], 1024 * 2 * sizeof(int16_t), 0);

		int32_t bmxl = 0;
		int32_t bmxr = 0;
		const int16_t* ptr = (const int16_t*)buffer[i];
		for (int32_t j = 0; j < 1024; ++j)
		{
			const int32_t s = ptr[j * 2 + 0] + ptr[j * 2 + 1];
			hist[j >> 3] = (s >> 9);

			bmxl = (int32_t)max(abs(ptr[j * 2 + 0]), bmxl);
			bmxr = (int32_t)max(abs(ptr[j * 2 + 1]), bmxr);
		}

		bmxl >>= 9;
		bmxr >>= 9;

		Cl = (bmxl > Cl) ? bmxl : ( Cl - ( (Cl > 8) ? 8 : Cl ) );
		Cr = (bmxr > Cr) ? bmxr : ( Cr - ( (Cr > 8) ? 8 : Cr ) );

		rt_input_set_tb_color(max(Cl, Cr));

		rt_audio_wait_any(1 << 0);
		rt_audio_play(0, buffer[i], 1024, RT_AUDIO_MODE_APPEND | RT_AUDIO_MODE_STEREO);
		i = (i + 1) & 3;
	}


	return 0;
}
