apistol78/retrodack/code/ScummRV/backends/rv/rv.cpp

#include <stdio.h>
#include <stdlib.h>

#include <HAL/DMA.h>
#include <HAL/Sprite.h>

#include <Runtime/Audio.h>
#include <Runtime/Input.h>
#include <Runtime/Kernel.h>
#include <Runtime/Runtime.h>
#include <Runtime/Timer.h>
#include <Runtime/Video.h>

#include "rv.h"

namespace
{

const int MAX_MOUSE_W = 80;
const int MAX_MOUSE_H = 80;
const int MAX_SCALING = 3;

int32_t clamp(int32_t v, int32_t mn, int32_t mx)
{
	return
		v < mn ? mn :
		v > mx ? mx :
		v;
}

int32_t map_key(uint8_t kc, uint8_t ch)
{
/*
	if (kc == RT_KEY_ESCAPE)
		return 27;
	else if (kc == RT_KEY_F5)
		return 319;		// F5
	else if (kc == RT_KEY_SPACE)
		return 32;		
	else
		return ch;
*/
	return 0;
}

OSystem_RebelV* _this = nullptr;

}

OSystem_RebelV::OSystem_RebelV()
{
	uint32_t tid;

	// runtime_init();
	rt_video_set_mode(VMODE_320_200_8);
	rt_audio_set_playback_rate(22050);

	_this = this;

	tid = rt_kernel_create_thread([](){
		for (;;) {
			_this->update_timer();
		}
	}, "rv timer");

	tid = rt_kernel_create_thread([](){
		for (;;) {
			_this->update_sound();
		}
	}, "rv sound");

	tid = rt_kernel_create_thread([](){
		for (;;) {
			_this->update_frame();
		}
	}, "rv update");

	m_target = (byte*)rt_video_create_target();

	rt_input_show_cursor();
}

void OSystem_RebelV::init_size(uint w, uint h)
{
	for (int i = 0; i < 256; ++i)
	{
		const uint8_t r = rand();
		const uint8_t g = rand();
		const uint8_t b = rand();
		m_palette[i] = { r, g, b };
		rt_video_set_palette(
			i,
			(r << 16) | (g << 8) | (b)
		);
	}

	m_overlayTarget = (byte*)rt_video_create_target();
}

void OSystem_RebelV::set_palette(const byte *colors, uint start, uint num)
{
	for (uint i = 0; i < num; ++i)
	{
		const uint8_t r = colors[0];
		const uint8_t g = colors[1];
		const uint8_t b = colors[2];
		m_palette[start + i] = { r, g, b };
		colors += 4;
	}
	m_paletteDirty = true;
}

void OSystem_RebelV::copy_rect(const byte *src, int pitch, int x, int y, int w, int h)
{
	x = x & ~7;
	w = (w + 7) & ~7;

	if (x < 0) {
		w += x;
		src -= x;
		x = 0;
	}

	if (y < 0) {
		h += y;
		src -= (y * pitch) >> 1;
		y = 0;
	}
	if (w > 320 - x) {
		w = 320 - x;
	}

	if (h > 200 - y) {
		h = 200 - y;
	}

	if (w <= 0 || h <= 0)
		return;

	byte *dst = m_target + y * 320 + x;
	do {
		memcpy(dst, src, w);
		dst += 320;
		src += pitch;
	} while (--h);
}

void OSystem_RebelV::move_screen(int dx, int dy, int height)
{
	// printf("move_screen\n");
}

void OSystem_RebelV::update_screen()
{
}

void OSystem_RebelV::set_shake_pos(int shake_pos)
{
	// printf("set_shake_pos\n");
}

NewGuiColor OSystem_RebelV::RGBToColor(uint8 r, uint8 g, uint8 b)
{
	uint8_t nearest = 255;
	uint8_t check;
	uint8_t r2, g2, b2;

	uint8_t color = 255;

	for (int32_t i = 0; i < 256; i++)
	{
		r2 = m_palette[i].r;
		g2 = m_palette[i].g;
		b2 = m_palette[i].b;

		check = (abs(r2 - r) + abs(g2 - g) + abs(b2 - b)) / 3;

		if (check == 0)
			return i;
		else if (check < nearest)
		{
			color = i;
			nearest = check;
		}
	}

	return color;
}

void OSystem_RebelV::colorToRGB(NewGuiColor color, uint8 &r, uint8 &g, uint8 &b)
{
	const auto& c = m_palette[color];
	r = c.r;
	g = c.g;
	b = c.b;
}

bool OSystem_RebelV::show_mouse(bool visible)
{
	const bool last = m_mouseVisible;
	m_mouseVisible = visible;
	hal_sprite_set_visible(0, visible ? 0xff : 0x00);
	return last;
}

void OSystem_RebelV::warp_mouse(int x, int y)
{
	rt_input_set_absolute_position(x, y);
}

void OSystem_RebelV::set_mouse_cursor(const byte *buf, uint w, uint h, int hotspot_x, int hotspot_y)
{
	hal_sprite_set_bits(0, buf, (int32_t)w, (int32_t)h);
	rt_input_set_hotspot(hotspot_x, hotspot_y);
}

uint32 OSystem_RebelV::get_msecs()
{
	return rt_timer_get_ms();
}

void OSystem_RebelV::delay_msecs(uint msecs)
{
	rt_kernel_sleep(msecs);
}

void OSystem_RebelV::set_timer(TimerProc callback, int timer)
{
	m_timerInterval = timer;
	m_timerExpire = rt_timer_get_ms() + timer;
	m_timerCallback = callback;
}

bool OSystem_RebelV::poll_event(Event *event)
{
	rt_event_t ev;
	if (rt_input_get_event(&ev) > 0)
	{
		event->mouse.x = ev.x;
		event->mouse.y = ev.y;

		if (ev.button == 0)
		{
			event->event_code = EVENT_MOUSEMOVE;
			return true;
		}
		else
		{

			if (ev.button == RT_INPUT_BUTTON_A || ev.button == RT_INPUT_TB)
				event->event_code = ev.pressed ? EVENT_LBUTTONDOWN : EVENT_LBUTTONUP;
			else if (ev.button == RT_INPUT_BUTTON_B)
				event->event_code = ev.pressed ? EVENT_RBUTTONDOWN : EVENT_RBUTTONUP;
			else if (ev.button == RT_INPUT_BUTTON_S1)
			{
				// Escape
				event->event_code = ev.pressed ? EVENT_KEYDOWN : EVENT_KEYUP;
				event->kbd.keycode = 27;
				event->kbd.ascii = 27;
			}
			else if (ev.button == RT_INPUT_BUTTON_S2)
			{
				// F5
				event->event_code = ev.pressed ? EVENT_KEYDOWN : EVENT_KEYUP;
				event->kbd.keycode = 319;
				event->kbd.ascii = 319;
			}
			else if (ev.button == RT_INPUT_DPAD_W)
			{
				// Simon quicksave 0
				event->event_code = ev.pressed ? EVENT_KEYDOWN : EVENT_KEYUP;
				event->kbd.keycode = '0';
				event->kbd.ascii = '0';				
				event->kbd.flags = OSystem::KBD_ALT;
			}
			else if (ev.button == RT_INPUT_DPAD_E)
			{
				// Simon quickload 0
				event->event_code = ev.pressed ? EVENT_KEYDOWN : EVENT_KEYUP;
				event->kbd.keycode = '0';
				event->kbd.ascii = '0';				
				event->kbd.flags = OSystem::KBD_CTRL;
			}			
			else
				return false;

			return true;
		}
	}
	return false;
}

bool OSystem_RebelV::set_sound_proc(SoundProc proc, void *param, SoundFormat format)
{
	m_soundParam = param;
	m_soundProc = proc;
	return true;
}

void OSystem_RebelV::clear_sound_proc()
{
	m_soundProc = nullptr;
	m_soundParam = nullptr;
}

bool OSystem_RebelV::poll_cdrom()
{
	return false;
}

void OSystem_RebelV::play_cdrom(int track, int num_loops, int start_frame, int duration)
{
	// printf("play_cdrom\n");
}

void OSystem_RebelV::stop_cdrom()
{
	// printf("stop_cdrom\n");
}

void OSystem_RebelV::update_cdrom()
{
	// printf("update_cdrom\n");
}

OSystem::MutexRef OSystem_RebelV::create_mutex()
{
	kernel_cs_t* cs = new kernel_cs_t();
	rt_kernel_cs_init(cs);
	return (OSystem::MutexRef)cs;
}

void OSystem_RebelV::lock_mutex(MutexRef mutex)
{
	kernel_cs_t* cs = (kernel_cs_t*)mutex;
	rt_kernel_cs_lock(cs);
}

void OSystem_RebelV::unlock_mutex(MutexRef mutex)
{
	kernel_cs_t* cs = (kernel_cs_t*)mutex;
	rt_kernel_cs_unlock(cs);
}

void OSystem_RebelV::delete_mutex(MutexRef mutex)
{
	kernel_cs_t* cs = (kernel_cs_t*)mutex;
	delete cs;
}

void OSystem_RebelV::show_overlay()
{
	if (m_overlayVisible)
		return;

	uint32_t tag = hal_dma_copy(m_overlayTarget, m_target, 320 * 200 / 4);
	while (hal_dma_retired() < tag)
		rt_kernel_yield();

	// memcpy(m_overlayTarget, m_target, 320 * 200);

	m_overlayVisible = true;
}

void OSystem_RebelV::hide_overlay()
{
	if (!m_overlayVisible)
		return;

	clear_overlay();
	m_overlayVisible = false;
}

void OSystem_RebelV::clear_overlay()
{
	if (!m_overlayVisible)
		return;

	uint32_t tag = hal_dma_copy(m_overlayTarget, m_target, 320 * 200 / 4);
	while (hal_dma_retired() < tag)
		rt_kernel_yield();

	// memcpy(m_overlayTarget, m_target, 320 * 200);
}

void OSystem_RebelV::grab_overlay(NewGuiColor *buf, int pitch)
{
	const uint8_t* src = m_overlayTarget;
	for (int32_t i = 0; i < 200; ++i)
	{
		memcpy(buf, src, 320);
		src += 320;
		buf += pitch;
	}
}

void OSystem_RebelV::copy_rect_overlay(const NewGuiColor *buf, int pitch, int x, int y, int w, int h)
{
	if (x < 0)
	{
		w += x;
		buf -= x;
		x = 0;
	}

	if (y < 0)
	{
		h += y;
		buf -= y * pitch;
		y = 0;
	}

	if (w > 320 - x)
		w = 320 - x;

	if (h > 200 - y)
		h = 200 - y;

	if (w <= 0 || h <= 0)
		return;

	uint8_t* dst = m_overlayTarget + y * 320 + x;
	do
	{
		memcpy(dst, buf, w);
		dst += 320;
		buf += pitch;
	}
	while (--h);
}

uint32 OSystem_RebelV::property(int param, Property *value)
{
	switch (param)
	{
	case PROP_SET_WINDOW_CAPTION:
		return 1;
	case PROP_OPEN_CD:
		break;
	case PROP_TOGGLE_ASPECT_RATIO:
		break;
	case PROP_GET_SAMPLE_RATE:
		return 22050;
	case PROP_HAS_SCALER:
		return 0;
	}
	return 0;
}

void OSystem_RebelV::quit()
{
	runtime_cold_restart();
}

void OSystem_RebelV::update_sound()
{
	const int32_t NumSamples = 1024;
	static int32_t buf[8][NumSamples];
	static int32_t toggle = 0;

	if (m_soundProc)
	{
		m_soundProc(m_soundParam, (byte*)buf[toggle], sizeof(buf[toggle]));
		
		rt_audio_wait_any(1 << 0);
		rt_audio_play(0, buf[toggle], NumSamples, RT_AUDIO_MODE_APPEND | RT_AUDIO_MODE_STEREO);

		toggle = (toggle + 1) & 7;
	}
	else
		rt_kernel_sleep(100);
}

void OSystem_RebelV::update_timer()
{
	const uint32_t ms = rt_timer_get_ms();
	if (ms >= m_timerExpire || ms < m_lastTime)
	{
		if (m_timerCallback)
			m_timerCallback(m_timerInterval);
		m_timerExpire = ms + m_timerInterval;
	}
	m_lastTime = ms;
	rt_kernel_sleep(30);
}

void OSystem_RebelV::update_frame()
{
	if (m_paletteDirty)
	{
		m_paletteDirty = false;
		for (int32_t i = 0; i < 256; ++i)
		{
			const auto& c = m_palette[i];
			rt_video_set_palette(i, (c.r << 16) | (c.g << 8) | (c.b));
		}
	}

	if (m_overlayVisible)
		rt_video_blit(m_overlayTarget);
	else
	  	rt_video_blit(m_target);

	rt_video_wait();
	rt_video_present(1);
}

OSystem *OSystem_RebelV_create()
{ 
	return new OSystem_RebelV();
}
