apistol78/retrodack/code/ScummRV/scumm/imuse_digi/dimuse_codecs.cpp

/* ScummVM - Scumm Interpreter
 * Copyright (C) 2001-2004 The ScummVM project
 *
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
 * $Header: /cvsroot/scummvm/scummvm/scumm/imuse_digi/dimuse_codecs.cpp,v 1.3 2004/01/08 15:48:41 aquadran Exp $
 */

#include "stdafx.h"
#include "common/scummsys.h"
#include "common/util.h"

namespace Scumm {

namespace BundleCodecs {

uint32 decode12BitsSample(byte *src, byte **dst, uint32 size) {
	uint32 loop_size = size / 3;
	uint32 s_size = loop_size * 4;
	byte *ptr = *dst = (byte *)malloc(s_size);

	uint32 tmp;
	while (loop_size--) {
		byte v1 = *src++;
		byte v2 = *src++;
		byte v3 = *src++;
		tmp = ((((v2 & 0x0f) << 8) | v1) << 4) - 0x8000;
		WRITE_BE_UINT16(ptr, tmp); ptr += 2;
		tmp = ((((v2 & 0xf0) << 4) | v3) << 4) - 0x8000;
		WRITE_BE_UINT16(ptr, tmp); ptr += 2;
	}
	return s_size;
}

#ifdef __PALM_OS__
static byte *_destImcTable = NULL;		// save 23k of memory !
static uint32 *_destImcTable2 = NULL;

static const int16 *imcTable;
#else
static byte _destImcTable[93];
static uint32 _destImcTable2[5697];

static const int16 imcTable[] = {
	0x0007, 0x0008, 0x0009, 0x000A, 0x000B, 0x000C, 0x000D, 0x000E, 0x0010, 0x0011,
	0x0013, 0x0015, 0x0017, 0x0019, 0x001C, 0x001F, 0x0022, 0x0025, 0x0029, 0x002D,
	0x0032, 0x0037, 0x003C, 0x0042, 0x0049, 0x0050, 0x0058, 0x0061, 0x006B, 0x0076,
	0x0082, 0x008F, 0x009D, 0x00AD, 0x00BE, 0x00D1, 0x00E6, 0x00FD, 0x0117, 0x0133,
	0x0151, 0x0173, 0x0198, 0x01C1, 0x01EE, 0x0220, 0x0256, 0x0292, 0x02D4, 0x031C,
	0x036C, 0x03C3, 0x0424, 0x048E, 0x0502, 0x0583, 0x0610, 0x06AB, 0x0756, 0x0812,
	0x08E0, 0x09C3, 0x0ABD, 0x0BD0, 0x0CFF, 0x0E4C, 0x0FBA, 0x114C, 0x1307, 0x14EE,
	0x1706, 0x1954, 0x1BDC, 0x1EA5, 0x21B6, 0x2515, 0x28CA, 0x2CDF, 0x315B, 0x364B,
	0x3BB9, 0x41B2, 0x4844, 0x4F7E, 0x5771, 0x602F, 0x69CE, 0x7462, 0x7FFF
};
#endif
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
