apistol78/retrodack/code/Runtime/Input.c

/*
 RetroDÄCK
 Copyright (c) 2025-2026 Anders Pistol.

 This Source Code Form is subject to the terms of the Mozilla Public
 License, v. 2.0. If a copy of the MPL was not distributed with this
 file, You can obtain one at https://mozilla.org/MPL/2.0/.
*/
#include <stdio.h>
#include <string.h>
#include "Runtime/Cursor.h"
#include "Runtime/I2C.h"
#include "Runtime/Input.h"
#include "Runtime/Kernel.h"
#include "Runtime/Video.h"

#include <HAL/Interrupt.h>
#include <HAL/Sprite.h>
#include <HAL/Timer.h>
#include <HAL/Video.h>

#define TRACKBALL_REG_LED_RED 0x00
#define TRACKBALL_REG_LED_GRN 0x01
#define TRACKBALL_REG_LED_BLU 0x02
#define TRACKBALL_REG_LED_WHT 0x03

#define TRACKBALL_REG_LEFT 0x04
#define TRACKBALL_REG_RIGHT 0x05
#define TRACKBALL_REG_UP 0x06
#define TRACKBALL_REG_DOWN 0x07
#define TRACKBALL_REG_SWITCH 0x08
#define TRACKBALL_MSK_SWITCH_STATE 0b10000000

#define TRACKBALL_REG_USER_FLASH 0xD0
#define TRACKBALL_REG_FLASH_PAGE 0xF0
#define TRACKBALL_REG_INT 0xF9
#define TRACKBALL_MSK_INT_TRIGGERED 0b00000001
#define TRACKBALL_MSK_INT_OUT_EN 0b00000010
#define TRACKBALL_REG_CHIP_ID_L 0xFA
#define TRACKBALL_RED_CHIP_ID_H 0xFB
#define TRACKBALL_REG_VERSION 0xFC
#define TRACKBALL_REG_I2C_ADDR 0xFD
#define TRACKBALL_REG_CTRL 0xFE
#define TRACKBALL_MSK_CTRL_SLEEP 0b00000001
#define TRACKBALL_MSK_CTRL_RESET 0b00000010
#define TRACKBALL_MSK_CTRL_FREAD 0b00000100
#define TRACKBALL_MSK_CTRL_FWRITE 0b00001000
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
