apistol78/retrodack/(commit log)

2025-05-09 Added initial parts document.
    [Parts.ods]
2025-05-11 A lot of work; beginning of mainboard schematics, SoC setup etc.
    [LFE5U-25F-5BG256-Pinout.csv, Parts.ods, mainboard.kicad_pcb, mainboard.kicad_sch, parts.ods, pin-clock.csv, pin-lcd.csv, pin-sd.csv]
2025-05-11 Begun SRAM symbol. Reorganized a bit on mainboard.
    [mainboard.kicad_pcb, mainboard.kicad_sch]
2025-05-12 Much work on mainboard.
    [mainboard.kicad_pcb, mainboard.kicad_sch, parts.ods, pin-usb-hci.csv]
2025-05-12 Layed out some PCB tracks.
    [mainboard.kicad_pcb, mainboard.kicad_sch, mainboard.step]
2025-05-13 Built in UART in icesugar working, able to write from C++ to host.
    [mainboard.kicad_sch, pin-sd.csv, pin-uart.csv, pin-usb-hci.csv, pinout.csv, sodimm.csv]
2025-05-13 More mainboard schematics work.
    [mainboard.kicad_pcb, mainboard.kicad_sch, mainboard.step]
2025-05-13 SDRAM controller added, basic tests seems to work.
    [pin-clock.csv, pin-sdram.csv]
2025-05-14 Proper placement of screen on PCB.
    [mainboard.kicad_pcb]
2025-05-14 Added PLIC, Timer, UART, Bridge peripherals. Ported over firmware and runtime from Rv32 project.
    [mkfs.xlsx]
2025-05-15 Trace length tuned for LCD and SRAM. Also reduced size of board a bit.
    [mainboard.kicad_pcb, mainboard.kicad_sch]
2025-05-15 More work on mainboard schematic.
    [mainboard.kicad_pcb, mainboard.kicad_sch]
2025-05-15 Mainboard schematics, audio system and power traces.
    [mainboard.kicad_pcb, mainboard.kicad_sch, parts.ods]
2025-05-16 SD card connector fixed in schematics. Added JLCPBC part numbers to some components.
    [mainboard.kicad_pcb, mainboard.kicad_sch, parts.ods]
2025-05-16 Some adjustments to Parts document.
    [parts.ods]
2025-05-17 Audio evaluation PCB added
    [audio_eval01.kicad_pcb, audio_eval01.kicad_sch]
2025-05-18 Audio evaluation board work.
    [audio_eval01.kicad_pcb, audio_eval01.kicad_sch]
2025-05-19 Minor DRC fixes to Audio evaluation board.
    [audio_eval01.kicad_pcb, audio_eval01.kicad_sch]
2025-05-20 Prepared Audio evaluation board for manufacture.
    [BOM-audio.csv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]
2025-05-21 Reset circuit added to audio evaluation board.
    [audio_eval01.kicad_pcb, audio_eval01.kicad_sch]
2025-05-21 Experiment with I2C and trackball device.
    [pin-i2c.csv, pin-usb-hci.csv]
2025-05-21 Added connector for trackball to mainboard schematics.
    [mainboard.kicad_pcb, mainboard.kicad_sch]
2025-05-21 Typo in Interrupt.c fixed.
2025-05-21 Added a link to suitable audio jack for the audio eval board.
    [audio_eval01.kicad_sch]
2025-05-22 Audio eval PCB sent to manufacturing.
    [BOM-audio.csv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]
2025-05-23 Begun implementing support for automatically generate a FS image from folder in emulator.
    [mkfs.xlsx]
2025-05-25 Updated mainboard to use I2S audio.
    [mainboard.kicad_pcb, mainboard.kicad_sch]
2025-05-25 Mainboard work, trying to figure out optimal outline.
    [mainboard.kicad_pcb, mainboard.kicad_sch]
2025-05-25 Added option to record trace to emulator.
2025-05-25 Ensure to call crt_init in firmware so printf are working properly.
2025-05-26 Added video device to emulator. Begun work on Dashboard software.
    [pin-sd.csv]
2025-05-27 Added "button board". Also placed LCD on main board at correct location.
    [buttboard.kicad_pcb, buttboard.kicad_sch, buttboard.step, mainboard.kicad_pcb, mainboard.kicad_sch, mainboard.step]
2025-05-27 Flat flex connector for interconnect.
    [mainboard.kicad_pcb, mainboard.kicad_sch]
2025-05-27 Some cleanup in mainboard.
    [mainboard.kicad_pcb, mainboard.kicad_sch]
2025-05-28 Added load switch to mainboard to control startup.
    [mainboard.kicad_pcb, mainboard.kicad_sch]
2025-05-28 Mounting points for mainboard added. Adjusted position of track ball on buttboard.
    [buttboard.kicad_pcb, buttboard.step, mainboard.kicad_pcb, mainboard.kicad_sch, mainboard.step]
2025-05-30 Added I2S audio device to SoC.
    [pin-i2s.csv]
2025-05-31 Added (internal) SD card to system.
    [pin-sd.csv]
2025-06-01 Mounting internal and external SD device in Emulator.
2025-06-01 Audio evaluation board tested with I2S device and SOC.
    [pin-i2s.csv]
2025-06-02 Memory layout plan, and fixes for firmware.
    [ELF.c, ELF.h, File.c, Firmware.c, LoadELF.cpp, Main.cpp, RetroDACK.sv, Runtime.c]
2025-06-03 External SD pins updated; for testing using external PCB.
    [pin-sd.csv]
2025-06-03 Added fpgaboard kicad project for future expansion.
    [fpgaboard.kicad_pcb, fpgaboard.kicad_sch]
2025-06-04 Fixed loading of ELF from firmware.
    [ELF.c, File.c, Firmware.c, Main.cpp]
2025-06-04 Able to use internal SD card connector on icesugar pro.
    [pin-sd.csv]
2025-06-04 Added both internal and external SD devices to HW.
2025-06-05 Schematic work; I2C shared with trackball and audio chip.
    [mainboard.kicad_pcb, mainboard.kicad_sch]
2025-06-05 Added SPI Flash module for accessing on-board Flash for XIP execution of firmware.
    [pin-spi-flash.csv]
2025-06-05 Able to read HW flash chip using memory mapped device.
    [pin-spi-flash.csv]
2025-06-07 Stubbed audio interrupt output on DAC GPIO pin.
2025-06-07 Able to initialize trackball and audio (same I2C bus) and play audio on HW.
    [pin-sd.csv]
2025-06-07 Launch tool rewritten, able to reset and upload binary without having running software pool serial. Audio sample moved into Dashboard.
    [Audio.c, File.c, Firmware.c, Main.cpp, RetroDACK.sv, Runtime.c, Runtime.h, Send.cpp]
2025-06-07 I2C as an unknown device in emulator.
2025-06-07 Audio interrupt connected to SODIMM connector.
    [mainboard.kicad_sch]
2025-06-08 Moved firmware location on flash so enough space is allocated for bitstream. Also enabled all available devices in runtime init.
2025-06-09 Various cleanup. Also added VIDEO controller to RTL.
    [pin-i2c.csv]
2025-06-10 Some work on the mainboard.
    [mainboard.kicad_pcb, mainboard.kicad_sch]
2025-06-12 Revision 1 of mainboard finished and ordered from JLCPCB.
    [BOM-mainboard.csv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]
2025-06-13 Incorrect part number and also incorrect footprint fixed. Another attempt at JLCPCB.
    [BOM-mainboard.csv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]
2025-06-13 Added membrane button footprint to buttboard.
    [buttboard.kicad_pcb, buttboard.kicad_sch]
2025-06-16 Using (non working) emulator I2C device.
2025-06-16 Reverted back Dashboard main to be playing music.
    [Main.cpp]
2025-06-16 Increased baudrate on UART. Using SD card reader on FPGA board for now. Minor other tweaks.
    [pin-sd.csv]
2025-06-17 Updated design rules for fpgaboard.
    [fpgaboard.kicad_pcb, fpgaboard.kicad_sch]
2025-06-18 Running emulator SOC in a separate thread.
2025-06-18 Added trackball device to I2C bus in emulator.
2025-06-25 Trackball emulator device work.
2025-06-30 Actual mainboard hardware work; display, vram, audio, sd card etc.
    [mainboard.kicad_pcb, mainboard.kicad_sch, pin-i2c.csv, pin-i2s.csv, pin-lcd.csv, pin-sd.csv, pin-sdram.csv, pin-sram.csv]
2025-07-01 Added GPIO extender device to emulator. Some work on input runtime.
2025-07-01 Begun work on mainboard rev 2; fixed SD card and also CE pin on SRAM fixed.
    [mainboard.kicad_pcb, mainboard.kicad_sch]
2025-07-03 HW pins and top level setup. Verified GPIO extender and GPIO interrupt.
    [pin-i2c.csv, pin-lcd.csv, pin-sd.csv]
2025-07-03 Replaced membrane buttons with tactile buttons on buttboard.
    [buttboard.kicad_pcb, buttboard.kicad_sch]
2025-07-03 More work on buttboard.
    [buttboard.kicad_pcb, buttboard.kicad_sch]
2025-07-03 Added control buttons to buttboard; adjusted cutout.
    [buttboard.kicad_pcb, buttboard.kicad_sch, buttboard.step]
2025-07-09 Attempt to send line multiple times before failing.
    [Send.cpp]
2025-07-13 Button board ordered from JLCPCB.
    [BOM-buttboard.csv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]
2025-07-13 Reset timer wall time when runtime is initialized.
    [Runtime.c, Timer.c, Timer.h]
2025-07-16 Slight modification to build script; using read_verilog to read source into yosys. Also added ModPlayer sample.
2025-07-29 Added debug drawing of video in firmware so we can fix video controller timing.
    [Firmware.c]
2025-08-01 Revert "Added debug drawing of video in firmware so we can fix video controller timing."
    This reverts commit 0c270e1258039841cf61a44d37201311bf6f4210.
    [Firmware.c]
2025-08-01 Revert "Updated VIDEO_controller instance in RD top module."
    This reverts commit b516cc524e68dd1070d07c6e6fa24eb520875736.
    [RetroDACK.sv]
2025-08-02 Cleaned up build.run a bit; no longer create splash screen. Firmware size reduced, only initialize necessary systems to reduce size. Kernel using inline assembly to capture timer value when entering 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
    [Firmware.c, Kernel.c]
2025-08-05 Updated audio device.
2025-08-08 Reverted back UART speed.
    [Main.cpp, RetroDACK.sv]
2025-08-08 Wait longer after reset in launcher.
    [Main.cpp]
2025-08-08 Fixed initial stack pointer. Also memory layout fixed in emulator.
    [Main.cpp, RetroDACK.sv]
2025-08-09 Using DMA device; not verified on HW.
2025-08-09 Fixed DMA typo in top module.
    [RetroDACK.sv]
2025-08-10 More optimizations in RT video using DMA.
2025-08-10 Minor cleanup in top module. Also added DMA waits in Doom when blitting the frame due to tearing.
2025-08-10 Using DMA to write audio buffer to audio system.
2025-08-12 Do not attempt to initialize file system if no SD card inserted.
2025-08-13 Fixed incorrect address mapping of Timer device.
    [RetroDACK.sv]
2025-08-14 A lot of minor fixes; most notably DMA and Audio.
    [Audio.c, Audio.h, Console.c, Firmware.c, Input.c, Kernel.c, Main.cpp, RetroDACK.sv]
2025-08-14 Fixed UART address mapping.
    [RetroDACK.sv]
2025-08-18 Minor cleanup in SDL; able to disable printf trace.
2025-08-20 Filter of trackball input deltas.
2025-08-20 Slight tweaks to input filtering. Also reduced LCD backlight abit.
2025-08-24 Firmware updates, able to communicate through UART without explicitly going into "remote" mode.
2025-08-25 GDB server as a device to receive ticks from CPU.
2025-08-27 Quake compile issues fixed.
    [model.c, snd_ctr.c]
2025-09-09 Revert "Firmware updates, able to communicate through UART without explicitly going into "remote" mode."
    This reverts commit 9727644ebab89752526659782f05a817340735c4.
    [Firmware.c]
2025-09-10 Reset UART in firmware to ensure no noise has caused it to lock up.
    [Firmware.c, Main.cpp]
2025-09-10 Sample rate connected, not verified.
2025-09-10 Fixed incorrect address mapping to AUDIO_controller.
    [RetroDACK.sv]
2025-09-11 Moving sprite 0 from input interrupt.
2025-09-12 Added unknown device as sprite device in emulator.
2025-09-12 Kernel signal aware, added more guards against thread internal members.
2025-09-12 Warp mouse position in input. Set hot spot of mouse cursor. Replaced SW cursor with HW cursor in ScummRV.
    [Input.c, Input.h, rv.cpp, rv.h]
2025-09-13 Various software improvements. Simplified kernel and increased it frequency to 150 hz.
2025-09-14 Using I2C_v2 module, probably not working.
    [RetroDACK.sv]
2025-09-14 Set slow rate of I2C_v2 for debugging, need tweaking up when working.
2025-09-20 Using new I2C device, updated runtime accordingly. Works on HW.
2025-09-20 Only disable timer interrupt when enter critical region in kernel.
2025-09-21 Added another DMA channel, channel 0 used by audio and 1 used by video.
2025-09-21 Fixed race issue with enter/leave critical region in kernel.
    [Kernel.c, Kernel.h]
2025-09-21 A lot of improvements to runtime. Input filtering, kernel fixes etc.
    [Firmware.c, I2C.c, I2C.h, Input.c, Kernel.c, Kernel.h, Main.cpp, RetroDACK.sv]
2025-09-22 Added the Sprite device to emulator.
2025-09-22 Added video interrupt to emulator.
2025-10-02 USB device mass storage device; need firmware refactorization.
    [pin-usb-hci.csv]
2025-10-12 Improved error recovery when sending data to target through UART.
    [Send.cpp]
2025-10-19 SignalView widget added to Emulator to show interrupt signals.
2025-10-20 Emulator fixes for SPI device. Also using "comb" dcache implementation.
    [Main.cpp, RetroDACK.sv]
2025-10-22 Using bus directly when loading ELF in emulator; was missing data otherwise.
    [LoadELF.cpp, Main.cpp]
2025-10-22 Fixed incorrect string compare defines in ScummRV.
    [scummsys.h]
2025-10-23 Implemented _gettimeofday in CRT. Various fixes and improvements.
    [CRT.c, Input.c, Main.cpp, rv.cpp]
2025-10-24 TB and GPIO sharing interrupt line. Minor optimization in Kernel when trying to wait on an already raised signal.
2025-10-26 Some work on mainboard pcb, most bodges resolved.
    [mainboard.kicad_pcb, mainboard.kicad_sch]
2025-10-26 More work on mainboard, mostly done but need double checking.
    [mainboard.kicad_pcb, mainboard.kicad_sch]
2025-10-26 Slikscreen fixes.
    [mainboard.kicad_pcb, mainboard.kicad_sch]
2025-10-26 Fixed GPIO extender emulation device.
    [GPIOExtender.cpp]
2025-10-28 Minor tweaks to mainboard, 1 mm narrower at the widest position allow for proper on/off switch. Double checked the phone jack connections.
    [mainboard.kicad_pcb, mainboard.kicad_sch]
2025-10-29 Added RTC and NV storage to mainboard.
    [mainboard.kicad_pcb, mainboard.kicad_sch]
2025-11-02 Various improvments to emulator and apps. Using new HAL DMA.
2025-11-02 Mainboard PCB work, moved debug header down a bit and mapped JLCPCB parts.
    [BOM-mainboard.csv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]
2025-11-02 Logging some signals in VCD trace.
2025-11-02 Fix in LoadELF for write mask.
    [LoadELF.cpp]
2025-11-02 Begun wiring up BLE/BHE from SRAM to FPGA on mainboard.
    [mainboard.kicad_pcb, mainboard.kicad_sch]
2025-11-04 Hooked up go/stop buttons from toolbar in emulator.
2025-11-07 Disable interrupts while stepping in emulator. Set hotspot of cursor in firmware.
2025-11-07 Wired up BLE/BHE pins of the video SRAM on mainboard.
    [mainboard.kicad_pcb, mainboard.kicad_sch]
2025-11-17 Replaced ADC with a proper "Fuel Gauge" on mainboard.
    [mainboard.kicad_pcb, mainboard.kicad_sch]
2025-11-17 Almost wired up "Fuel Gauge".
    [mainboard.kicad_pcb]
2025-11-17 Some updates on netclasses.
    [mainboard.kicad_pcb]
2025-11-18 More cleanup in mainboard rev 2; should be ready for manufacturing.
    [mainboard.kicad_pcb, mainboard.kicad_sch]
2025-11-19 Some minor cleanups in mainboard.
    [mainboard.kicad_pcb]
2025-11-19 Added some parts to JLCPCB BOM.
2025-11-21 Mainboard Revision 2 - Ordered from JLCPCB.
    [BOM-mainboard.csv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]
2025-12-04 Updated oss-cad-suite package.
2025-12-09 Fixed issue with emulator trackball not triggering interrupts properly.
    [Main.cpp, TrackBallDevice.cpp]
2025-12-10 Able to reset signal. Video ensure to wait on next vblank.
    [Kernel.c, Kernel.h, Video.c]
2025-12-11 Rev 2 pin constraints. Battery and RTC support.
    [pin-debug.csv, pin-i2c.csv, pin-lcd.csv, pin-sram.csv]
2025-12-12 Using refactored single DMA engine instead of individual instances.
2025-12-12 Updated DMA device mapping in emulator.
2025-12-14 Using two DMA engines so audio and video can both be bus masters.
2025-12-21 Reverted DMA re-factorizations; using to simpler DMA modules again due to logic utilization.
    [Audio.c, Main.cpp, RetroDACK.sv, RetroDACK_IO.sv, Video.c]
2025-12-25 Added functions to play mono samples through HAL audio.
2025-12-30 Slightly simpler device mapping in Emulator.
2026-01-01 Hooked up "external interrupt enable" signal to PLIC to ensure interrupts are not issued while interrupts are disabled.
    [RetroDACK.sv]
2026-01-02 Audio fixes, new system works as designed. Investigated input issues and fixed stuck keys. Able to use HW SD read path.
    [Audio.c, Audio.h, Firmware.c, Input.c, RetroDACK.sv, RetroDACK_IO.sv, Runtime.c, Serial.cpp]
2026-01-03 Work on custom FPGA board with more RAM and beefier FPGA.
    [ECP5U85Pinout.csv, FPGA.kicad_sch, POWER.kicad_sch, RAM.kicad_sch, fpgaboard.kicad_pcb, fpgaboard.kicad_sch]
2026-01-04 Increased frequency of Kernel, improves cursor movement while base thread busy. Added background image to Tetris.
2026-01-05 Some work on FPGA board, adding some decoupling, SODIMM signals etc.
    [FPGA.kicad_sch, fpgaboard.kicad_pcb]
2026-01-06 FPGA board update; using 6 layer setup and "via in pad".
    [FPGA.kicad_sch, fpgaboard.kicad_pcb]
2026-01-06 Using audio interrupt to wait on channels not being busy; saving thread switching cost when waiting on a signal.
2026-01-06 Rerouting some wires on FPGA board.
    [FPGA.kicad_sch, fpgaboard.kicad_pcb]
2026-01-07 More work on FPGA board.
    [FPGA.kicad_sch, fpgaboard.kicad_pcb]
2026-01-08 Moved pin constraints into a separate folder; need to have another setup when FPGA board is finished.
    [pin-clock.csv, pin-debug.csv, pin-i2c.csv, pin-i2s.csv, pin-lcd.csv, pin-sd.csv, pin-sdram.csv, pin-spi-flash.csv]
2026-01-08 Added "fuel gauge" I2C device to emulator. Moved cursor bitmap into Runtime. Added battery charge indicator to console.
2026-01-08 Added RTC I2C emulator device.
2026-01-08 Top row of SODIMM wired up to FPGA in fpga board.
    [FPGA.kicad_sch, fpgaboard.kicad_pcb]
2026-01-10 Acquire/release I2C access.
2026-01-11 Begun working on FPGA board SODIMM bottom routing.
    [FPGA.kicad_sch, fpgaboard.kicad_pcb]
2026-01-12 Some work on FPGA board.
    [FPGA.kicad_sch, fpgaboard.kicad_pcb]
2026-01-12 SODIMM connector fully wired up to FPGA.
    [FPGA.kicad_sch, fpgaboard.kicad_pcb]
2026-01-13 Work on connecting up SDRAM to FPGA.
    [FPGA.kicad_sch, POWER.kicad_sch, RAM.kicad_sch, fpgaboard.kicad_pcb]
2026-01-21 Added interrupt and thread counters to Emulator to be able to debug those. Trying to figure out why some threads seem to get stuck waiting for signals.
    [Audio.c, Emulator.cpp, Emulator.h, Input.c, Kernel.c, Kernel.h, MainForm.cpp, MainForm.h]
2026-01-24 Reading kernel data from emulator to visualize kernel threads.
2026-01-24 Mostly emulator work. Exposing kernel thread names.
2026-02-12 HW stable again, a lot of debugging hooks added. Exposed a lot of registers and CPU stats through JTAG connection.
    [pin-debug.csv]
2026-02-14 Using DMA to transfer overlay onto screen in ScummRV instead of memcpy.
2026-02-14 Ensure target address to SD HAL is 4-byte aligned (also 4-byte aligned size) for future DMA read.
2026-02-18 Using slow I2C setting for trackball.
2026-02-18 Masked icons in launcher. Ensure SD card is reset when soft restart system.
    [ELF.c, Firmware.c, Graphics.c, Graphics.h, Runtime.c]
2026-02-20 Lots of fixes; cold reset when writing to ffff_ffff, firmware updates, I2C fixed, reverted changes in ScummRV audio etc.
    [Audio.c, Audio.h, CRT.c, Disk.c, Firmware.c, I2C.c, I2C.h, Input.c]
2026-02-24 Load sound samples in Audio RT. Added to tetris.
