apistol78/retrodack/(notices)

Notices in the files:
code/Quake/source/r_surf.c:
modify it under the terms of the GNU General Public License
code/Runtime/printf/README.md:
License: MIT
